pigatron-industries/xen_octasource/README.md

# OctaSource

A Eurorack synthesiser module with 8 control voltage outputs.

[Documentation](https://pigatron-industries.github.io/xen_octasource/)
