pigatron-industries/xen_octasource/docs/development.md

---
order: 3
---
# Development History

### MK1 Prototype

Used a [MikroElektronika PIXI Click](https://www.mikroe.com/pixi-click) for all inputs and outputs.

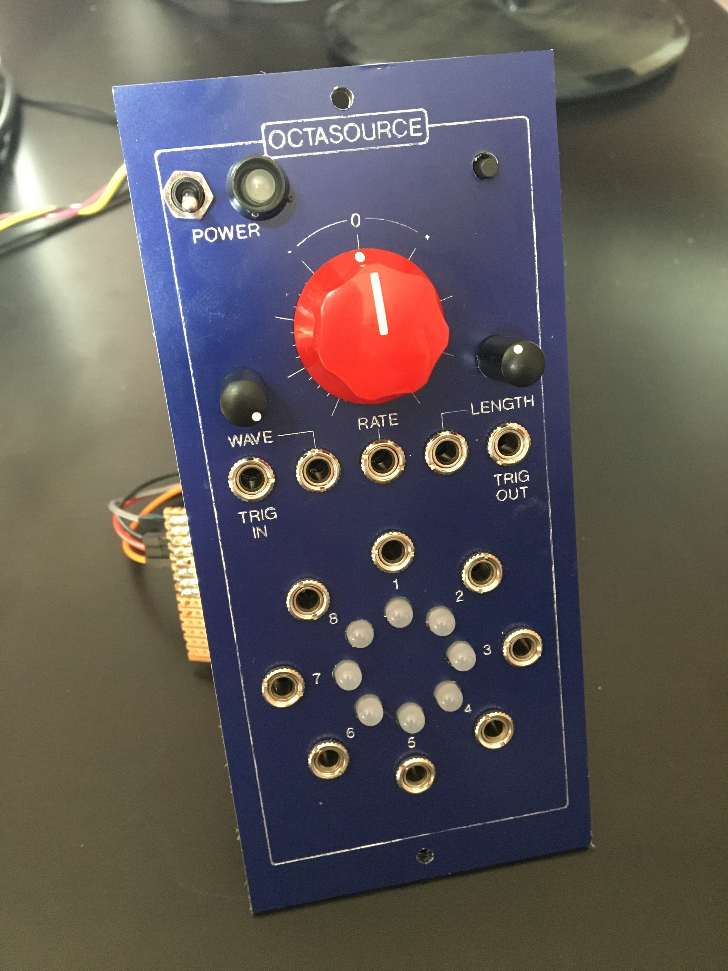
[picture p6: docs/images/octasource_mki_1.jpg]
 
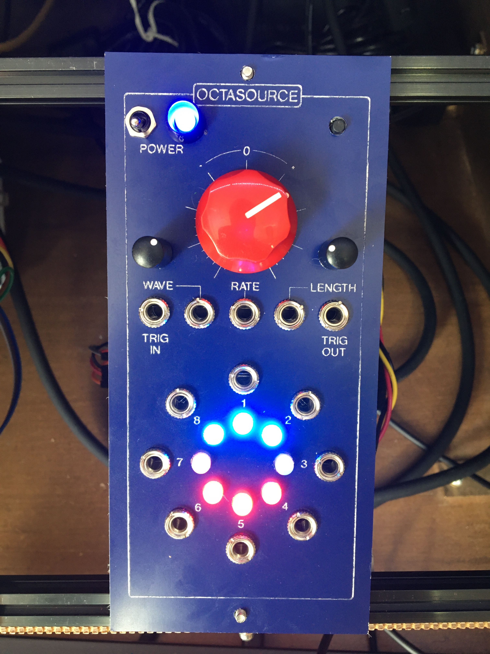
[picture p7: docs/images/octasource_mki_2.jpg]
 
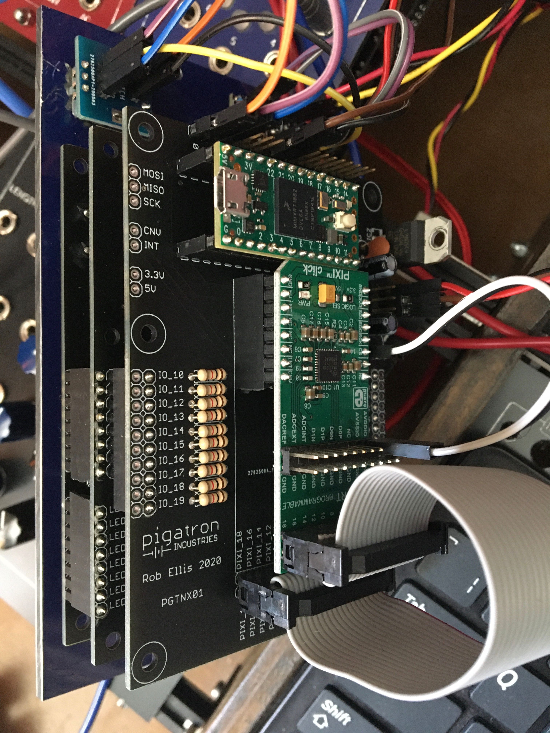
[picture p8: docs/images/octasource_mki_3.jpg]
