pigatron-industries/xen_octasource/docs/images/attractor_outputs.drawio.png

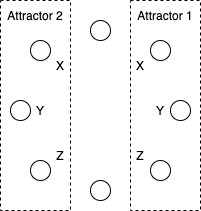
docs/images/attractor_outputs.drawio.png
