pigatron-industries/xen_octasource/docs/images/clock_divider2.drawio.png

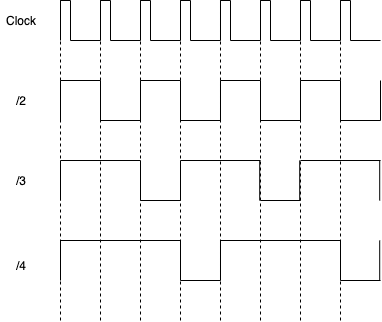
docs/images/clock_divider2.drawio.png
