pigatron-industries/xen_octasource/docs/images/clock_polyrhythm.drawio.png

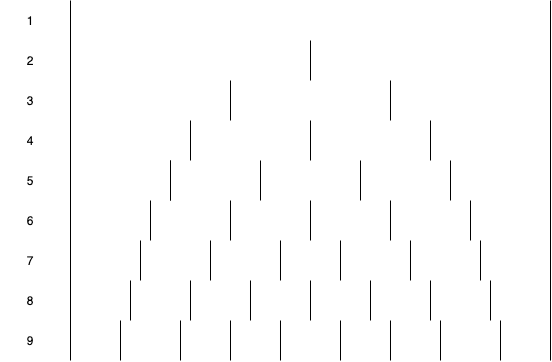
docs/images/clock_polyrhythm.drawio.png
