pigatron-industries/xen_octasource/docs/images/octasource_mkii_baseboard_brd.drawio.png

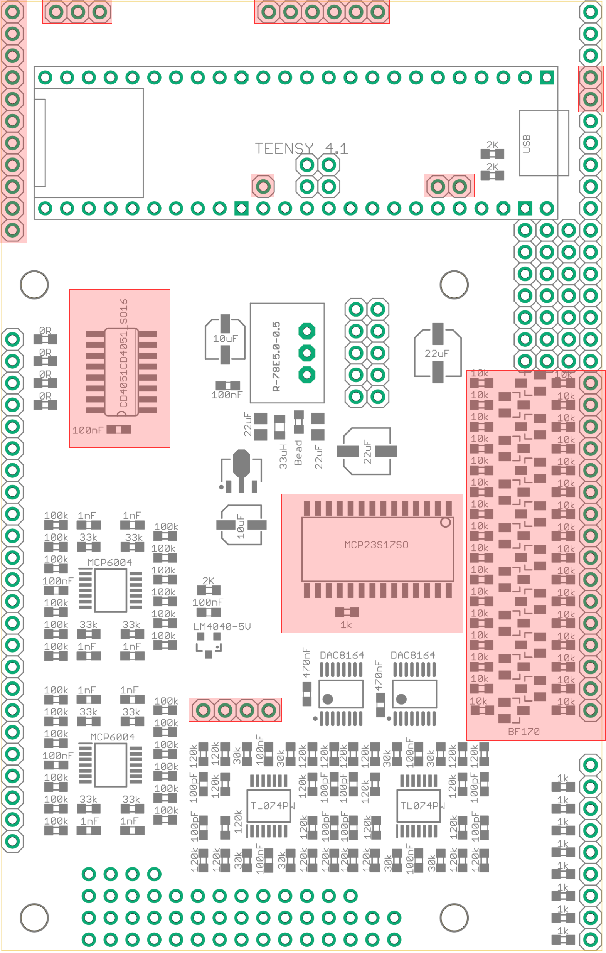
docs/images/octasource_mkii_baseboard_brd.drawio.png
