pigatron-industries/xen_octasource/docs/images/octasource_mkii_controls_brd_bottom.drawio.png

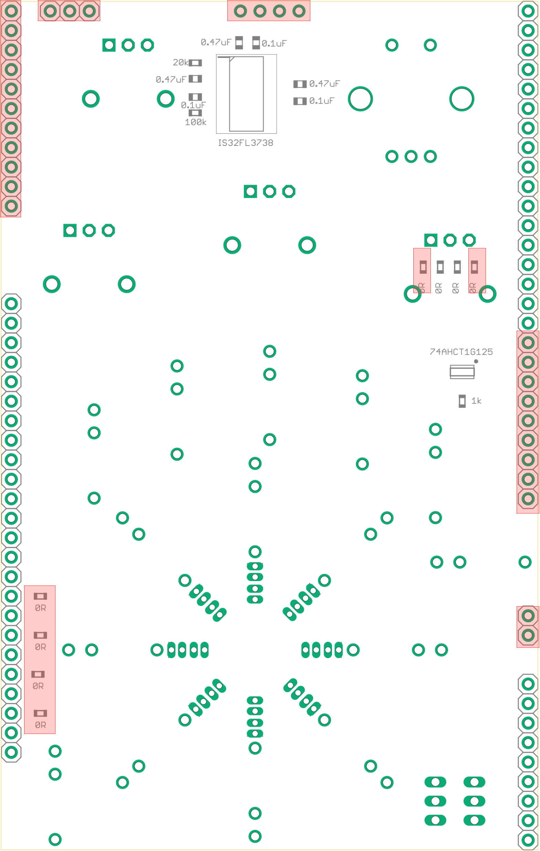
docs/images/octasource_mkii_controls_brd_bottom.drawio.png
