pigatron-industries/xen_octasource/docs/images/octasource_mkii_controls_brd_top.drawio.png

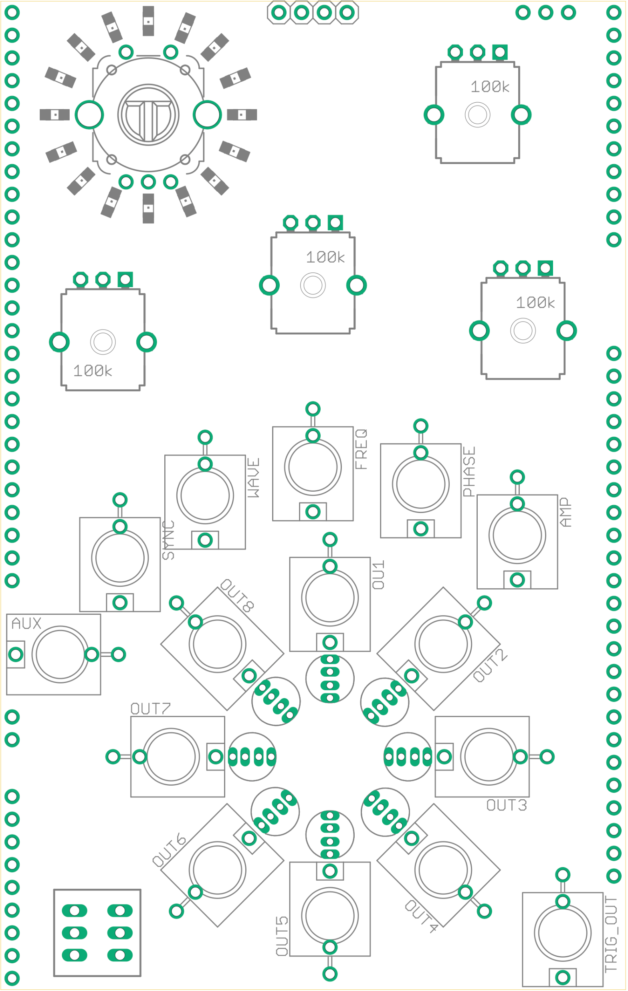
docs/images/octasource_mkii_controls_brd_top.drawio.png
