pigatron-industries/xen_octasource/docs/images/octosource_mkii.jpg

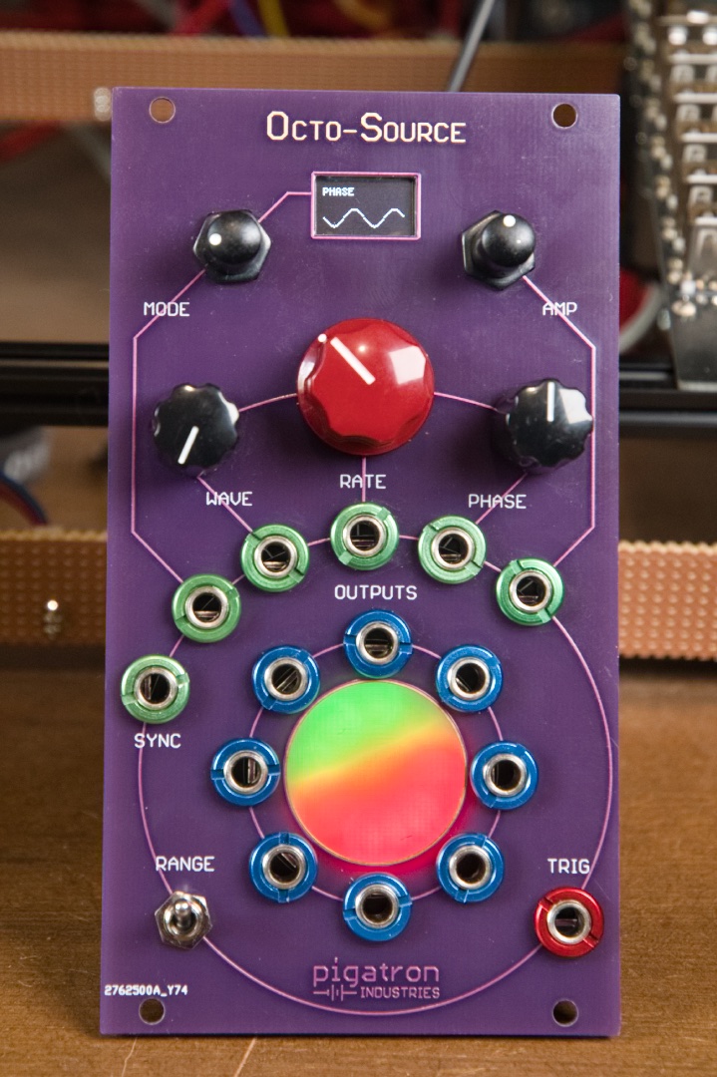
docs/images/octosource_mkii.jpg
