pigatron-industries/xen_octasource/docs/images/octosource_panel.png

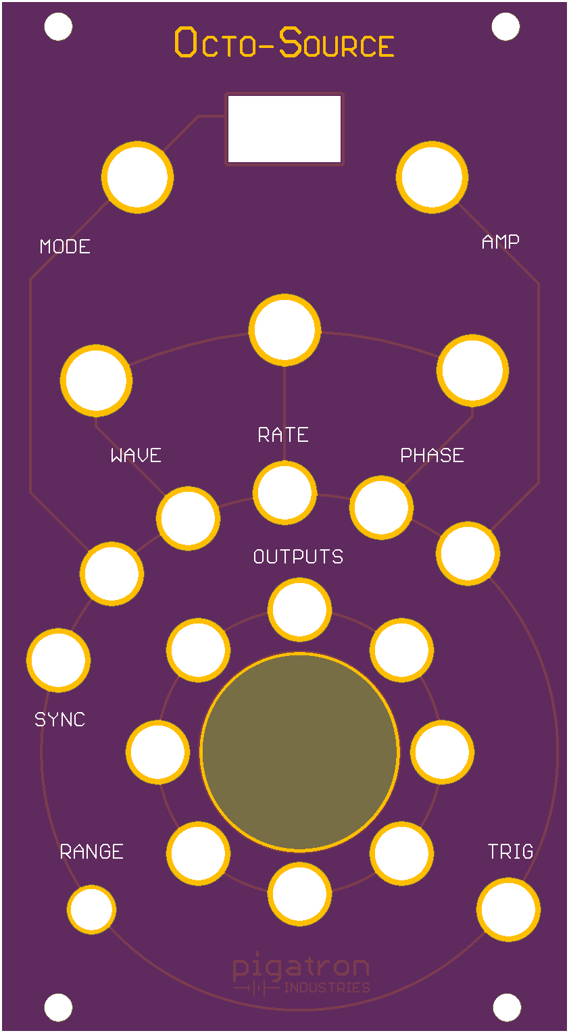
docs/images/octosource_panel.png
