pigatron-industries/xen_octasource/docs/images/pendulum_spring_outputs.drawio.png

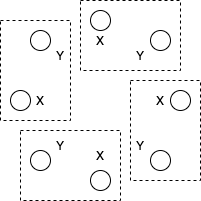
docs/images/pendulum_spring_outputs.drawio.png
