pigatron-industries/xen_octasource/docs/images/threebody_outputs.drawio.png

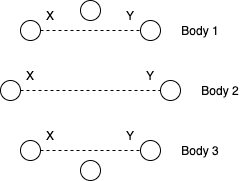
docs/images/threebody_outputs.drawio.png
