pigatron-industries/xen_octasource/docs/images/build/Photo 23-04-2022, 18 16 53.jpg

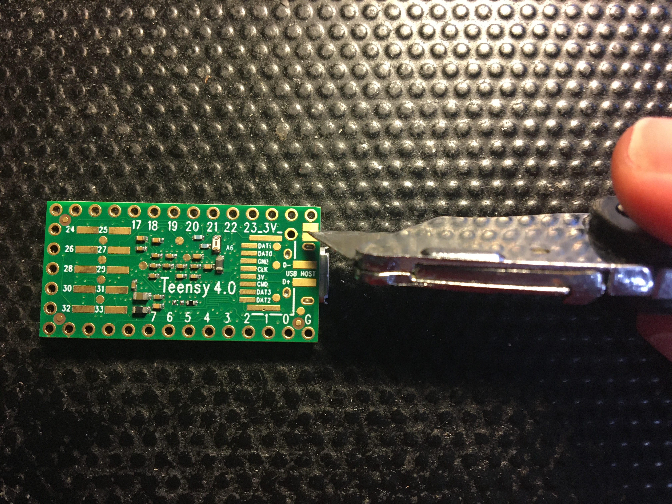
docs/images/build/Photo 23-04-2022, 18 16 53.jpg
