pigatron-industries/xen_octasource/docs/images/build/Photo 23-04-2022, 18 44 00.jpg

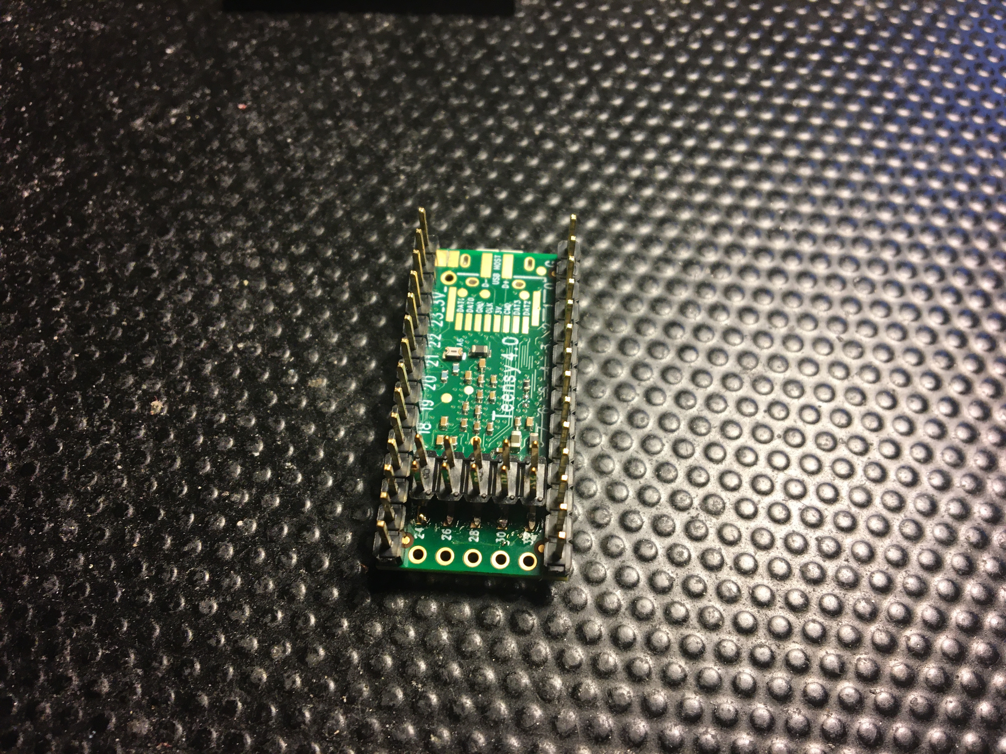
docs/images/build/Photo 23-04-2022, 18 44 00.jpg
