pigatron-industries/xen_octasource/docs/images/build/Photo 24-04-2022, 13 27 55.jpg

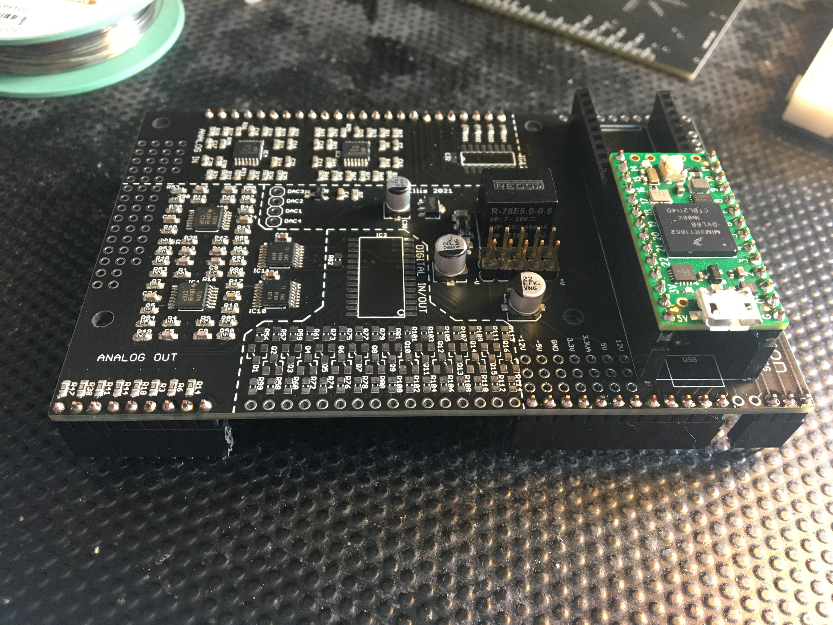
docs/images/build/Photo 24-04-2022, 13 27 55.jpg
