pigatron-industries/xen_octasource/docs/images/build/Photo 24-04-2022, 14 46 27.jpg

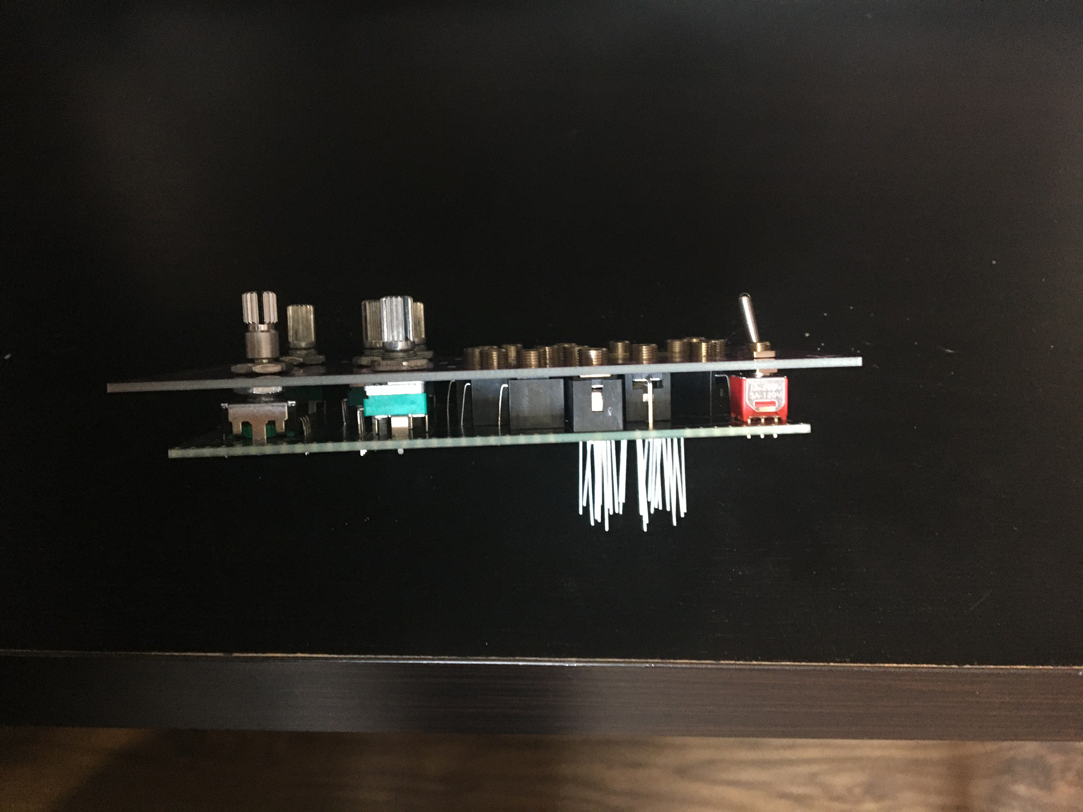
docs/images/build/Photo 24-04-2022, 14 46 27.jpg
