pigatron-industries/xen_octasource/docs/images/build/Photo 28-05-2022, 15 01 42.jpg

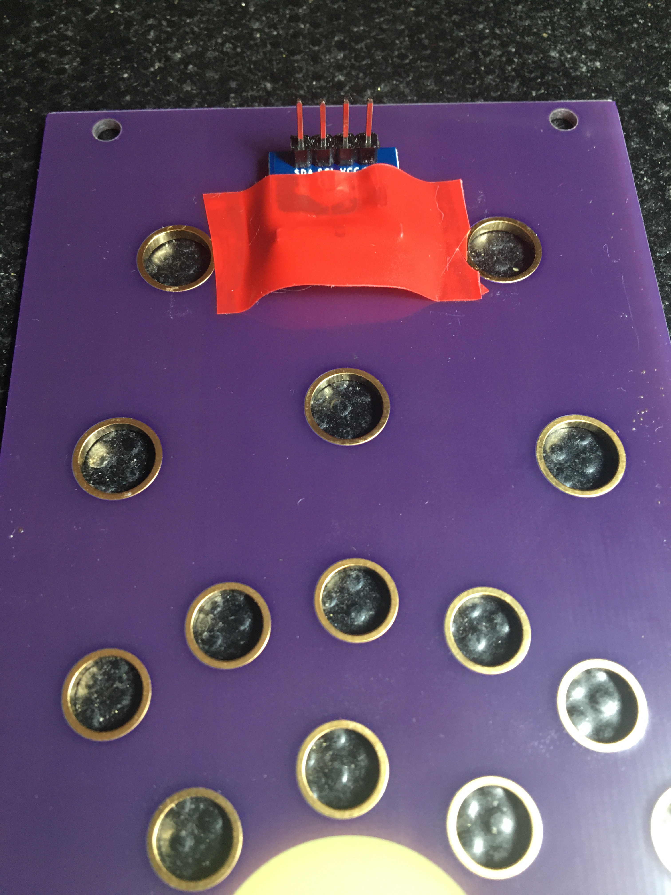
docs/images/build/Photo 28-05-2022, 15 01 42.jpg
