pigatron-industries/xen_octasource/docs/images/build/Photo 28-05-2022, 15 15 38.jpg

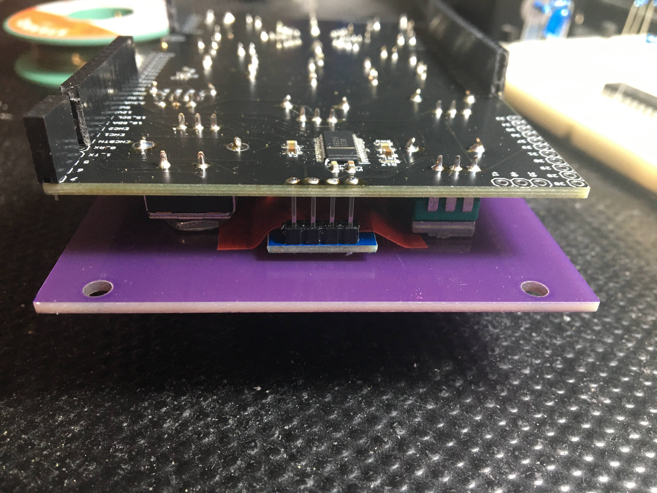
docs/images/build/Photo 28-05-2022, 15 15 38.jpg
