pigatron-industries/xen_octasource/docs/history.md

---
order: 5
---
# Development History

### MKII

{% include img.html src="images/octosource_mkii.jpg" height=400 %}

### MKI Prototype

Used a [MikroElektronika PIXI Click](https://www.mikroe.com/pixi-click) for all inputs and outputs.

{% include img.html src="images/octasource_mki_1.jpg" height=400 %} {% include img.html src="images/octasource_mki_2.jpg" height=400 %} {% include img.html src="images/octasource_mki_3.jpg" height=400 %}
