pigatron-industries/xen_octasource/hardware/mkiii/PGTN021_octasource_mkiii_panel.brd

## EAGLE design hardware/mkiii/PGTN021_octasource_mkiii_panel.brd (2023-10-28)

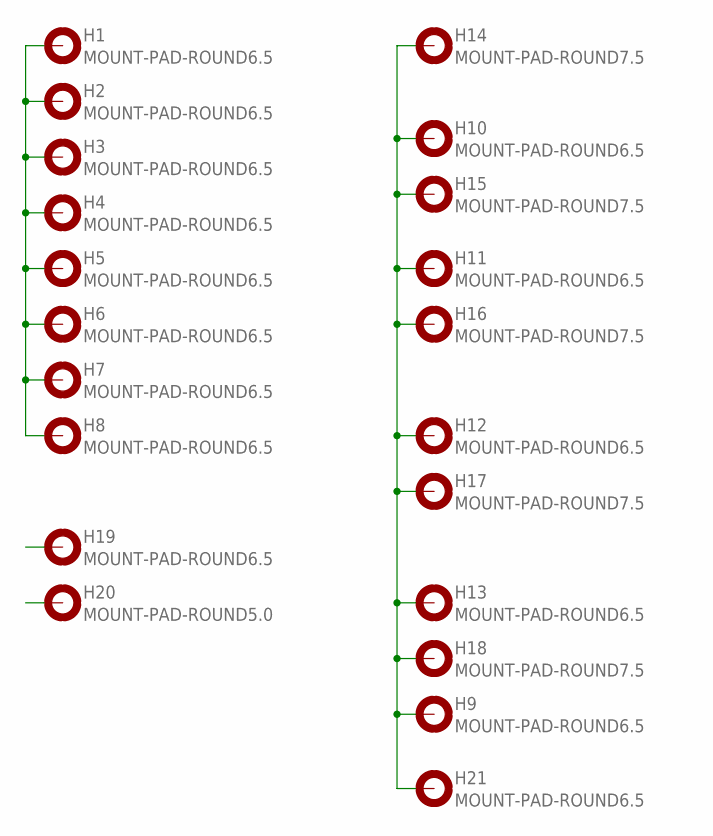
[picture p32: schematic PGTN021_octasource_mkiii_panel.sch]

Parts:
H1, H2, H3, H4, H5, H6, H7, H8, H9, H10, H11, H12, H13, H19, H21: MOUNT-PAD-ROUND6.5; 6.5-PAD
H14, H15, H16, H17, H18: MOUNT-PAD-ROUND7.5; 7.5-PAD
H20: MOUNT-PAD-ROUND5.0; 5,0-PAD

Connections:
unnamed: H9.B6.5, H10.B6.5, H11.B6.5, H12.B6.5, H13.B6.5, H14.B7.5, H15.B7.5, H16.B7.5, H17.B7.5, H18.B7.5, H21.B6.5
unnamed: H1.B6.5, H2.B6.5, H3.B6.5, H4.B6.5, H5.B6.5, H6.B6.5, H7.B6.5, H8.B6.5

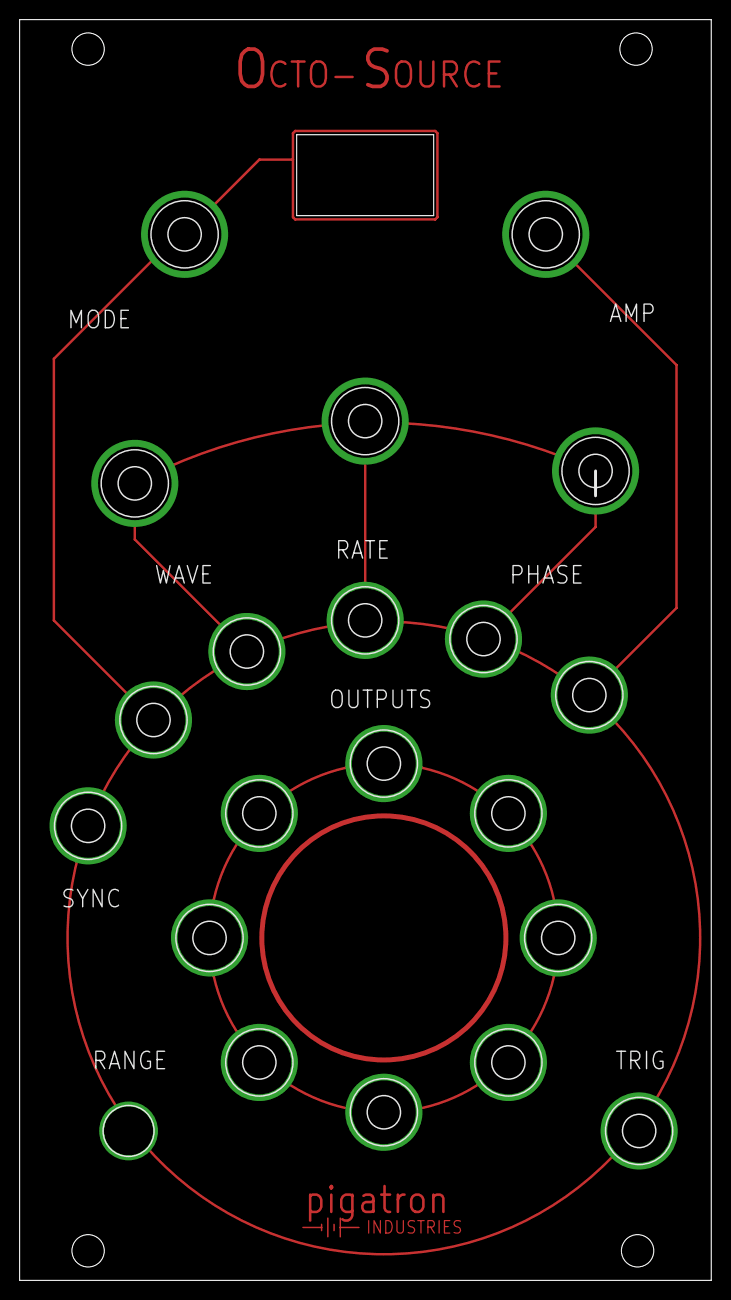
[picture p33: board PGTN021_octasource_mkiii_panel.brd from above]

Board: 2 copper layers, 70.5 x 128.6 mm, 26 parts (0 on the bottom side), 2 nets.

Other parts of the board:
U$1, U$3, U$4, U$5: 3,3
U$2: PIGATRON-LOGO-TRACE
