pigatron-industries/xen_octasource/hardware/mkiii/PGTN021_octasource_mkiii_controls.brd

## EAGLE design hardware/mkiii/PGTN021_octasource_mkiii_controls.brd (2023-10-28)

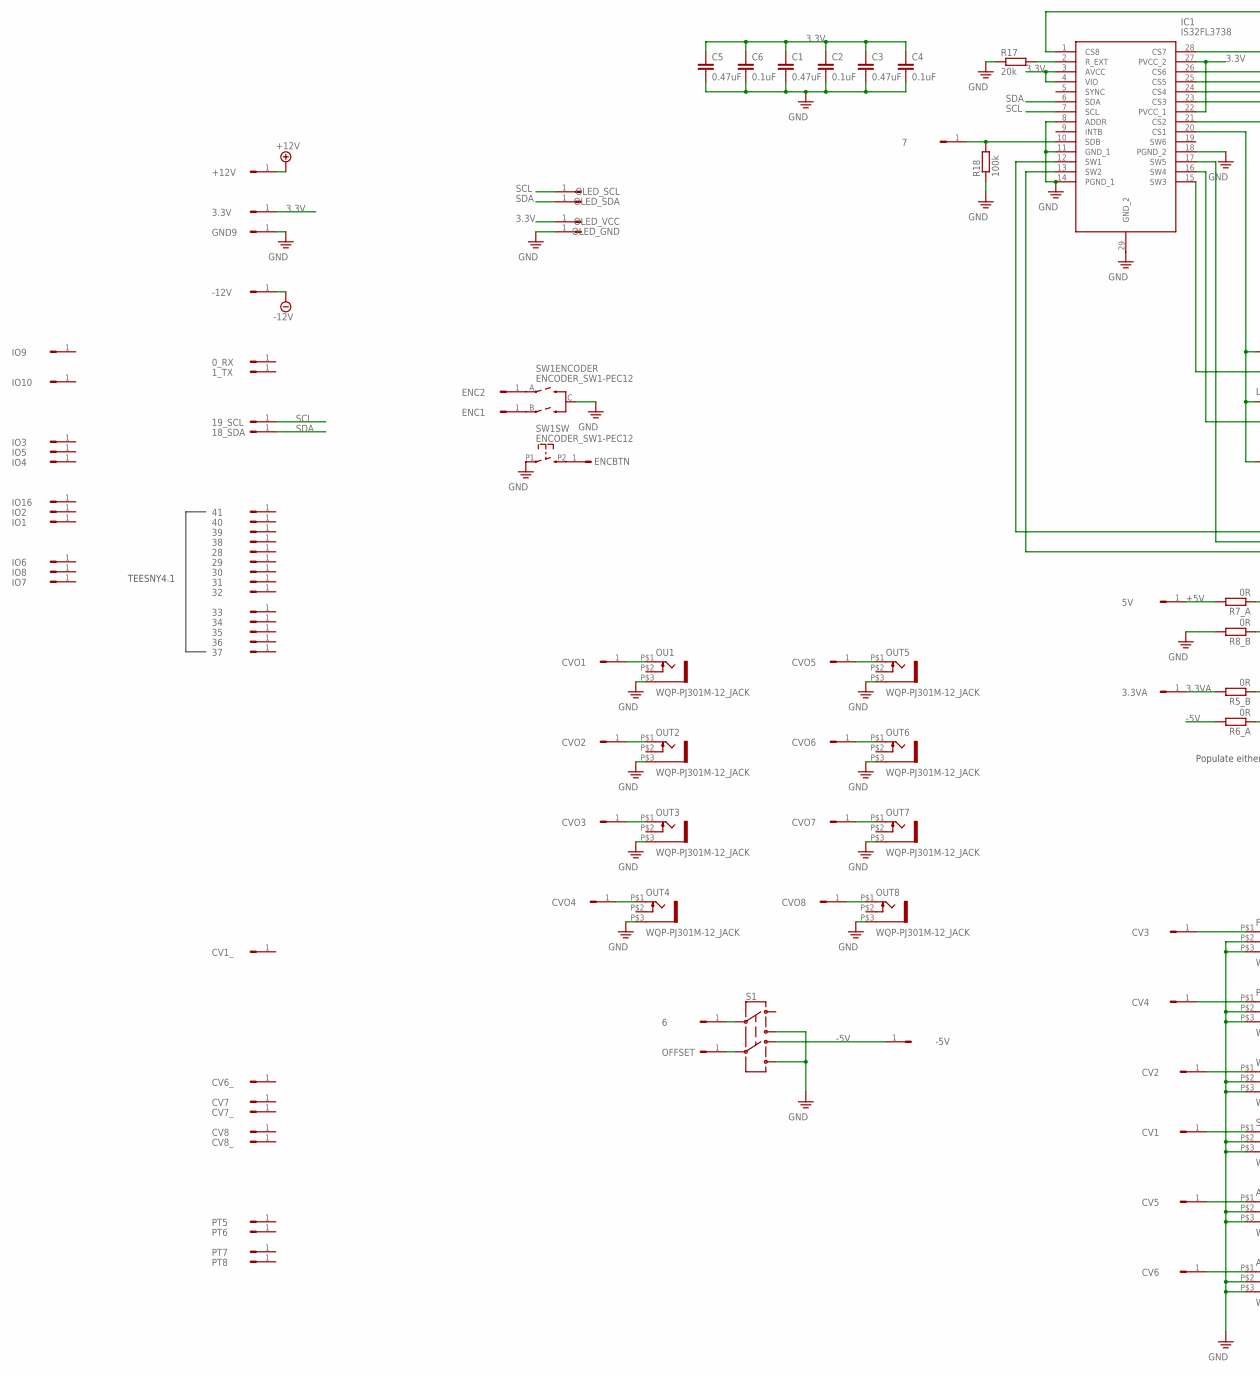
[picture p34: schematic PGTN021_octasource_mkiii_controls.sch, part in row 1, column 1]

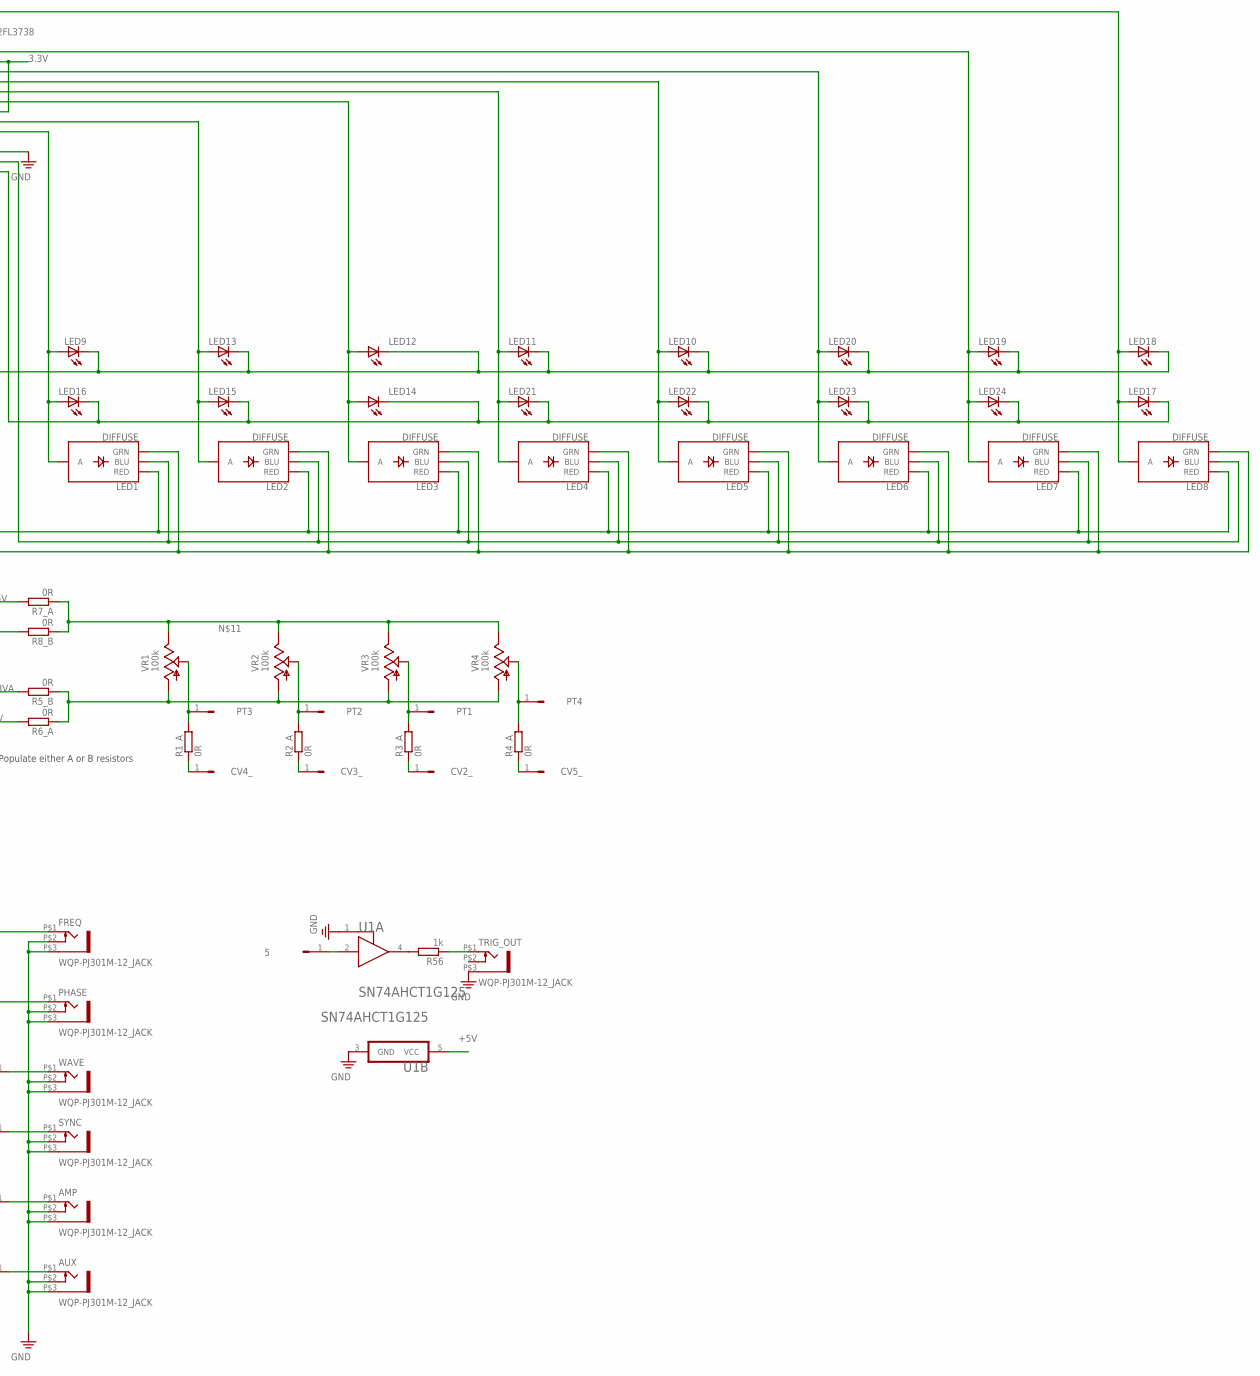
[picture p35: schematic PGTN021_octasource_mkiii_controls.sch, part in row 1, column 2]

Parts:
0_RX, 1_TX, 3.3V, 3.3VA, 5, 5V, 6, 7, 18_SDA, 19_SCL, 28, 29, 30, 31, 32, 33, 34, 35, 36, 37, 38, 39, 40, 41: HEADER/MALE/01
+12V: HEADER/MALE/01
-5V, -12V: HEADER/MALE/01
AMP: WQP-PJ301M-12_JACK
AUX: WQP-PJ301M-12_JACK
C1, C3, C5: 0.47uF; C0603
C2, C4, C6: 0.1uF; C0603
CV1, CV1_, CV2, CV2_, CV3, CV3_, CV4, CV4_, CV5, CV5_, CV6, CV6_, CV7, CV7_, CV8, CV8_: HEADER/MALE/01
CVO1, CVO2, CVO3, CVO4, CVO5, CVO6, CVO7, CVO8: HEADER/MALE/01
ENC1, ENC2: HEADER/MALE/01
ENCBTN: HEADER/MALE/01
FREQ: WQP-PJ301M-12_JACK
GND9: HEADER/MALE/01
IC1: IS32FL3738; TSSOP29
IO1, IO2, IO3, IO4, IO5, IO6, IO7, IO8, IO9, IO10, IO16: HEADER/MALE/01
LED1, LED2, LED3, LED4, LED5, LED6, LED7, LED8: DIFFUSE; LED-RGB-THRU
LED9, LED10, LED11, LED12, LED13, LED14, LED15, LED16, LED17, LED18, LED19, LED20, LED21, LED22, LED23, LED24: LEDCHIPLED_0805; CHIPLED_0805
OFFSET: HEADER/MALE/01
OLED_GND: HEADER/MALE/01
OLED_SCL: HEADER/MALE/01
OLED_SDA: HEADER/MALE/01
OLED_VCC: HEADER/MALE/01
OU1: WQP-PJ301M-12_JACK
OUT2, OUT3, OUT4, OUT5, OUT6, OUT7, OUT8: WQP-PJ301M-12_JACK
PHASE: WQP-PJ301M-12_JACK
PT1, PT2, PT3, PT4, PT5, PT6, PT7, PT8: HEADER/MALE/01
R1_A, R2_A, R3_A, R4_A, R5_B, R6_A, R7_A, R8_B: 0R; R0603
R17: 20k; R0603
R18: 100k; R0603
R56: 1k; R0603
S1: SWITCH-DPDTPTH2; SWITCH-DPDT_SUB_ROUND
SW1: ENCODER_SW1-PEC12; PEC12_INCREMENTAL_ENCODER
SYNC: WQP-PJ301M-12_JACK
TRIG_OUT: WQP-PJ301M-12_JACK
U1: 74AHCT1G125
VR1, VR2, VR3, VR4: 100k; 9MM_SNAP-IN_POT
WAVE: WQP-PJ301M-12_JACK

Connections:
3.3V: 3.3V.1, C1.1, C2.1, C3.1, C4.1, C5.1, C6.1, IC1.3 (AVCC), IC1.4 (VIO), IC1.22 (PVCC_1), IC1.27 (PVCC_2), OLED_VCC.1
3.3VA: 3.3VA.1, R5_B.2
+5V: 5V.1, R7_A.2, U1.5 (VCC)
+12V: +12V.1
-5V: -5V.1, R6_A.2, S1.4
-12V: -12V.1
unnamed: IC1.12 (SW1), LED1.1 (RED), LED2.1 (RED), LED3.1 (RED), LED4.1 (RED), LED5.1 (RED), LED6.1 (RED), LED7.1 (RED), LED8.1 (RED)
unnamed: PT3.1, R1_A.2, VR1.2 (S)
unnamed: IC1.17 (SW5), LED1.4 (BLU), LED2.4 (BLU), LED3.4 (BLU), LED4.4 (BLU), LED5.4 (BLU), LED6.4 (BLU), LED7.4 (BLU), LED8.4 (BLU)
unnamed: CVO1.1, OU1.P$1 (2)
unnamed: 6.1, S1.2
unnamed: IC1.13 (SW2), LED1.3 (GRN), LED2.3 (GRN), LED3.3 (GRN), LED4.3 (GRN), LED5.3 (GRN), LED6.3 (GRN), LED7.3 (GRN), LED8.3 (GRN)
unnamed: PT2.1, R2_A.2, VR2.2 (S)
unnamed: CVO2.1, OUT2.P$1 (2)
unnamed: PT1.1, R3_A.2, VR3.2 (S)
unnamed: PT4.1, R4_A.2, VR4.2 (S)
unnamed: R7_A.1, R8_B.1, VR1.3 (E), VR2.3 (E), VR3.3 (E), VR4.3 (E)
unnamed: CVO3.1, OUT3.P$1 (2)
unnamed: OFFSET.1, S1.5
unnamed: AUX.P$1 (2), CV6.1
unnamed: CV4_.1, R1_A.1
unnamed: CVO4.1, OUT4.P$1 (2)
unnamed: CV3_.1, R2_A.1
unnamed: CV2_.1, R3_A.1
unnamed: CV5_.1, R4_A.1
unnamed: CVO5.1, OUT5.P$1 (2)
unnamed: R5_B.1, R6_A.1, VR1.1 (A), VR2.1 (A), VR3.1 (A), VR4.1 (A)
unnamed: CVO6.1, OUT6.P$1 (2)
unnamed: CVO7.1, OUT7.P$1 (2)
unnamed: CVO8.1, OUT8.P$1 (2)
unnamed: 7.1, IC1.10 (SDB), R18.2
unnamed: R56.2, U1.4 (Y)
unnamed: 5.1, U1.2 (A)
unnamed: ENCBTN.1, SW1.P2 (2)
unnamed: ENC2.1, SW1.A
unnamed: ENC1.1, SW1.B
unnamed: CV1.1, SYNC.P$1 (2)
unnamed: CV2.1, WAVE.P$1 (2)
unnamed: CV3.1, FREQ.P$1 (2)
unnamed: CV4.1, PHASE.P$1 (2)
unnamed: AMP.P$1 (2), CV5.1
unnamed: R56.1, TRIG_OUT.P$1 (2)
unnamed: IC1.20 (CS1), LED1.2 (A), LED9.A, LED16.A
unnamed: IC1.21 (CS2), LED2.2 (A), LED13.A, LED15.A
unnamed: IC1.23 (CS3), LED3.2 (A), LED12.A, LED14.A
unnamed: IC1.16 (SW4), LED14.C, LED15.C, LED16.C, LED17.C, LED21.C, LED22.C, LED23.C, LED24.C
unnamed: IC1.15 (SW3), LED9.C, LED10.C, LED11.C, LED12.C, LED13.C, LED18.C, LED19.C, LED20.C
unnamed: IC1.24 (CS4), LED4.2 (A), LED11.A, LED21.A
unnamed: IC1.25 (CS5), LED5.2 (A), LED10.A, LED22.A
unnamed: IC1.26 (CS6), LED6.2 (A), LED20.A, LED23.A
unnamed: IC1.28 (CS7), LED7.2 (A), LED19.A, LED24.A
unnamed: IC1.1 (CS8), LED8.2 (A), LED17.A, LED18.A
unnamed: IC1.2 (R_EXT), R17.2
PE: AMP.P$2 (3), AMP.P$3 (1), AUX.P$2 (3), AUX.P$3 (1), C1.2, C2.2, C3.2, C4.2, C5.2, C6.2, FREQ.P$2 (3), FREQ.P$3 (1), GND9.1, IC1.8 (ADDR), IC1.11 (GND_1), IC1.14 (PGND_1), IC1.18 (PGND_2), IC1.29 (GND_2), OLED_GND.1, OU1.P$3 (1), OUT2.P$3 (1), OUT3.P$3 (1), OUT4.P$3 (1), OUT5.P$3 (1), OUT6.P$3 (1), OUT7.P$3 (1), OUT8.P$3 (1), PHASE.P$2 (3), PHASE.P$3 (1), R8_B.2, R17.1, R18.1, S1.3, S1.6, SW1.C, SW1.P1 (1), SYNC.P$2 (3), SYNC.P$3 (1), TRIG_OUT.P$3 (1), U1.1 (!OE!), U1.3 (GND), WAVE.P$2 (3), WAVE.P$3 (1)
SCL: 19_SCL.1, IC1.7 (SCL), OLED_SCL.1
SDA: 18_SDA.1, IC1.6 (SDA), OLED_SDA.1

Notes on the sheet:
TEESNY4.1
Populate either A or B resistors

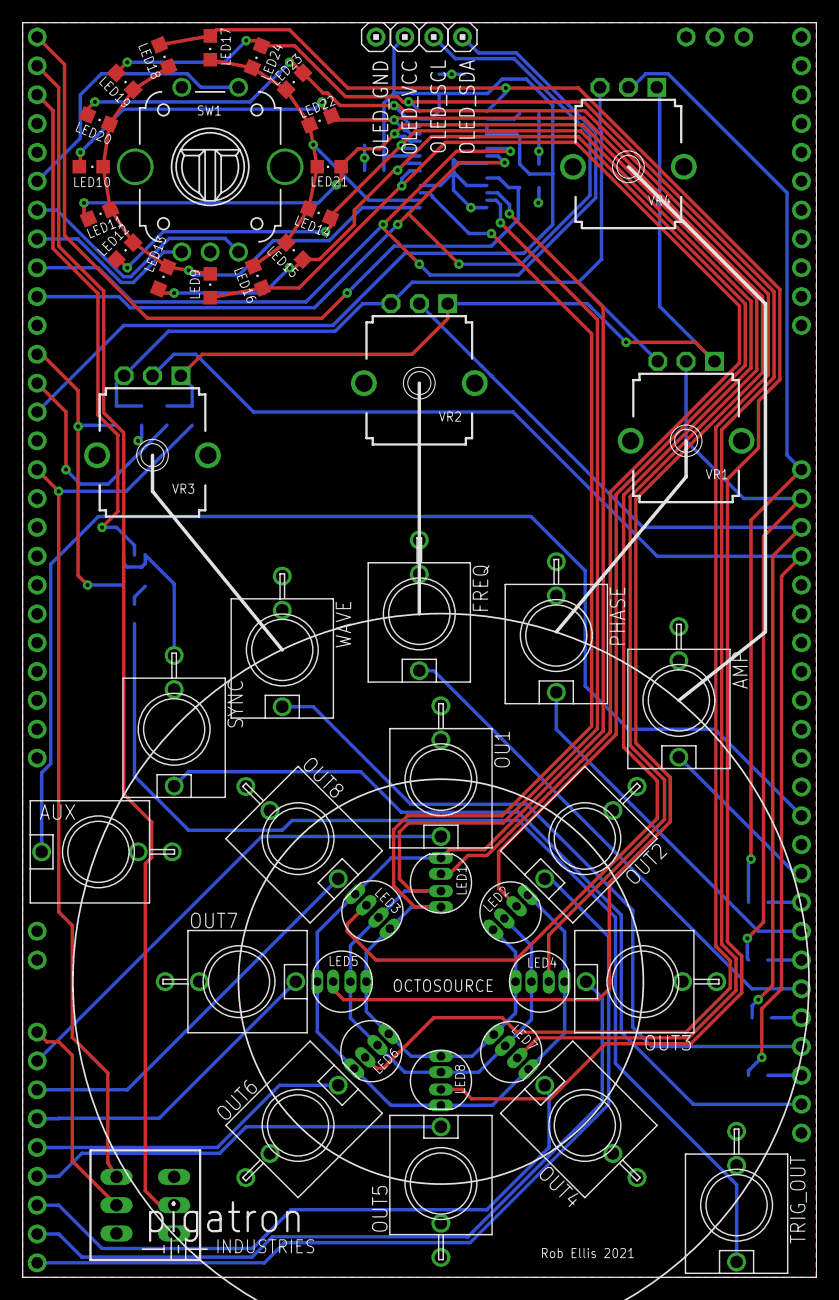
[picture p36: board PGTN021_octasource_mkiii_controls.brd from above]

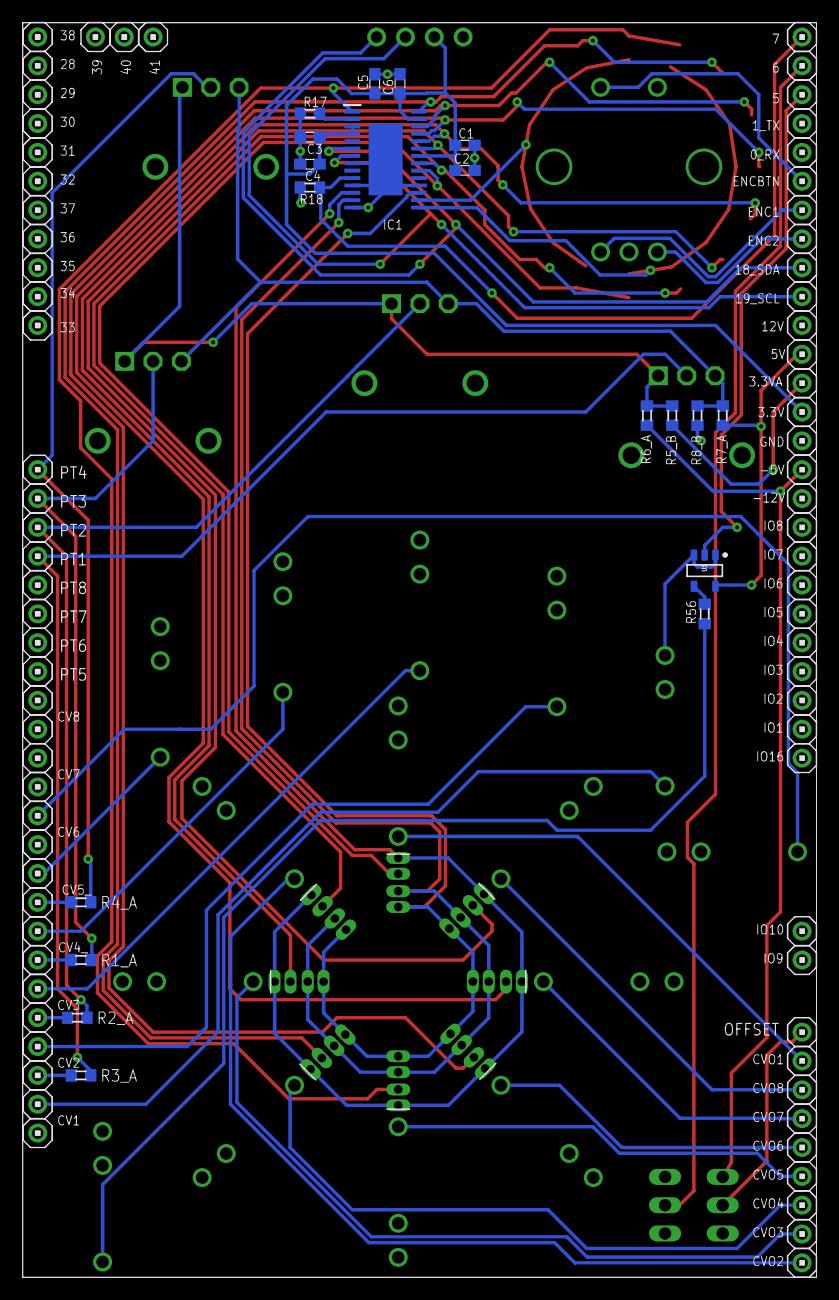
[picture p37: board PGTN021_octasource_mkiii_controls.brd from below]

Board: 2 copper layers, 69.9 x 110.5 mm, 144 parts (94 on the bottom side), 54 nets.

Other parts of the board:
U$1: PIGATRON-LOGO
