pigatron-industries/xen_octasource/hardware/mki/PGTN021_octasource_mki_controls.brd

## EAGLE design hardware/mki/PGTN021_octasource_mki_controls.brd (2021-05-31)

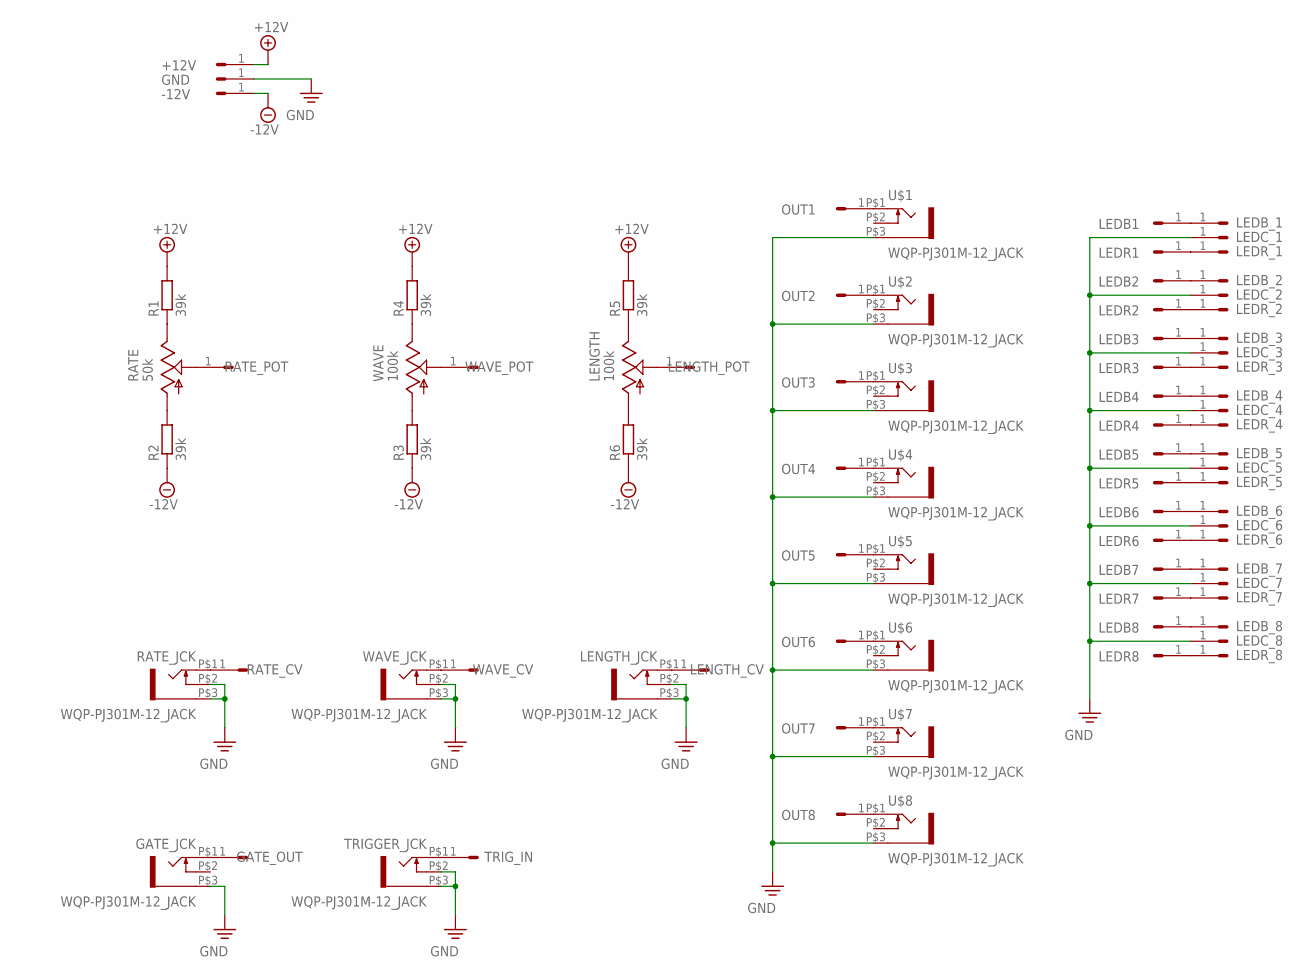
[picture p38: schematic PGTN021_octasource_mki_controls.sch]

Parts:
+12V: HEADER/MALE/01
-12V: HEADER/MALE/01
GATE_JCK: WQP-PJ301M-12_JACK
GATE_OUT: HEADER/MALE/01
GND: HEADER/MALE/01
LEDB1, LEDB2, LEDB3, LEDB4, LEDB5, LEDB6, LEDB7, LEDB8: HEADER/MALE/01
LEDB_1, LEDB_2, LEDB_3, LEDB_4, LEDB_5, LEDB_6, LEDB_7, LEDB_8: HEADER/MALE/01
LEDC_1, LEDC_2, LEDC_3, LEDC_4, LEDC_5, LEDC_6, LEDC_7, LEDC_8: HEADER/MALE/01
LEDR1, LEDR2, LEDR3, LEDR4, LEDR5, LEDR6, LEDR7, LEDR8: HEADER/MALE/01
LEDR_1, LEDR_2, LEDR_3, LEDR_4, LEDR_5, LEDR_6, LEDR_7, LEDR_8: HEADER/MALE/01
LENGTH: 100k; 9MM_SNAP-IN_POT
LENGTH_CV: HEADER/MALE/01
LENGTH_JCK: WQP-PJ301M-12_JACK
LENGTH_POT: HEADER/MALE/01
OUT1, OUT2, OUT3, OUT4, OUT5, OUT6, OUT7, OUT8: HEADER/MALE/01
R1, R2, R3, R4, R5, R6: 39k; RESISTOR/7.5
RATE: 50k; 9MM_SNAP-IN_POT
RATE_CV: HEADER/MALE/01
RATE_JCK: WQP-PJ301M-12_JACK
RATE_POT: HEADER/MALE/01
TRIGGER_JCK: WQP-PJ301M-12_JACK
TRIG_IN: HEADER/MALE/01
U$1, U$2, U$3, U$4, U$5, U$6, U$7, U$8: WQP-PJ301M-12_JACK
WAVE: 100k; 9MM_SNAP-IN_POT
WAVE_CV: HEADER/MALE/01
WAVE_JCK: WQP-PJ301M-12_JACK
WAVE_POT: HEADER/MALE/01

Connections:
+12V: +12V.1, R1.2, R4.2, R5.2
-12V: -12V.1, R2.1, R3.1, R6.1
unnamed: R2.2, RATE.1 (A)
unnamed: R1.1, RATE.3 (E)
unnamed: RATE_CV.1, RATE_JCK.P$1 (2)
unnamed: RATE.2 (S), RATE_POT.1
unnamed: R3.2, WAVE.1 (A)
unnamed: R4.1, WAVE.3 (E)
unnamed: WAVE.2 (S), WAVE_POT.1
unnamed: LENGTH.3 (E), R5.1
unnamed: LENGTH.1 (A), R6.2
unnamed: LENGTH.2 (S), LENGTH_POT.1
unnamed: LENGTH_CV.1, LENGTH_JCK.P$1 (2)
unnamed: WAVE_CV.1, WAVE_JCK.P$1 (2)
unnamed: GATE_JCK.P$1 (2), GATE_OUT.1
unnamed: OUT1.1, U$1.P$1 (2)
unnamed: OUT2.1, U$2.P$1 (2)
unnamed: OUT3.1, U$3.P$1 (2)
unnamed: OUT4.1, U$4.P$1 (2)
unnamed: OUT5.1, U$5.P$1 (2)
unnamed: OUT6.1, U$6.P$1 (2)
unnamed: OUT7.1, U$7.P$1 (2)
unnamed: OUT8.1, U$8.P$1 (2)
unnamed: LEDB1.1, LEDB_1.1
unnamed: LEDB2.1, LEDB_2.1
unnamed: LEDB3.1, LEDB_3.1
unnamed: LEDB4.1, LEDB_4.1
unnamed: LEDB5.1, LEDB_5.1
unnamed: LEDB6.1, LEDB_6.1
unnamed: LEDB7.1, LEDB_7.1
unnamed: LEDB8.1, LEDB_8.1
unnamed: LEDR1.1, LEDR_1.1
unnamed: LEDR2.1, LEDR_2.1
unnamed: LEDR3.1, LEDR_3.1
unnamed: LEDR4.1, LEDR_4.1
unnamed: LEDR5.1, LEDR_5.1
unnamed: LEDR6.1, LEDR_6.1
unnamed: LEDR7.1, LEDR_7.1
unnamed: LEDR8.1, LEDR_8.1
unnamed: TRIGGER_JCK.P$1 (2), TRIG_IN.1
PE: GATE_JCK.P$3 (1), GND.1, LEDC_1.1, LEDC_2.1, LEDC_3.1, LEDC_4.1, LEDC_5.1, LEDC_6.1, LEDC_7.1, LEDC_8.1, LENGTH_JCK.P$2 (3), LENGTH_JCK.P$3 (1), RATE_JCK.P$2 (3), RATE_JCK.P$3 (1), TRIGGER_JCK.P$2 (3), TRIGGER_JCK.P$3 (1), U$1.P$3 (1), U$2.P$3 (1), U$3.P$3 (1), U$4.P$3 (1), U$5.P$3 (1), U$6.P$3 (1), U$7.P$3 (1), U$8.P$3 (1), WAVE_JCK.P$2 (3), WAVE_JCK.P$3 (1)

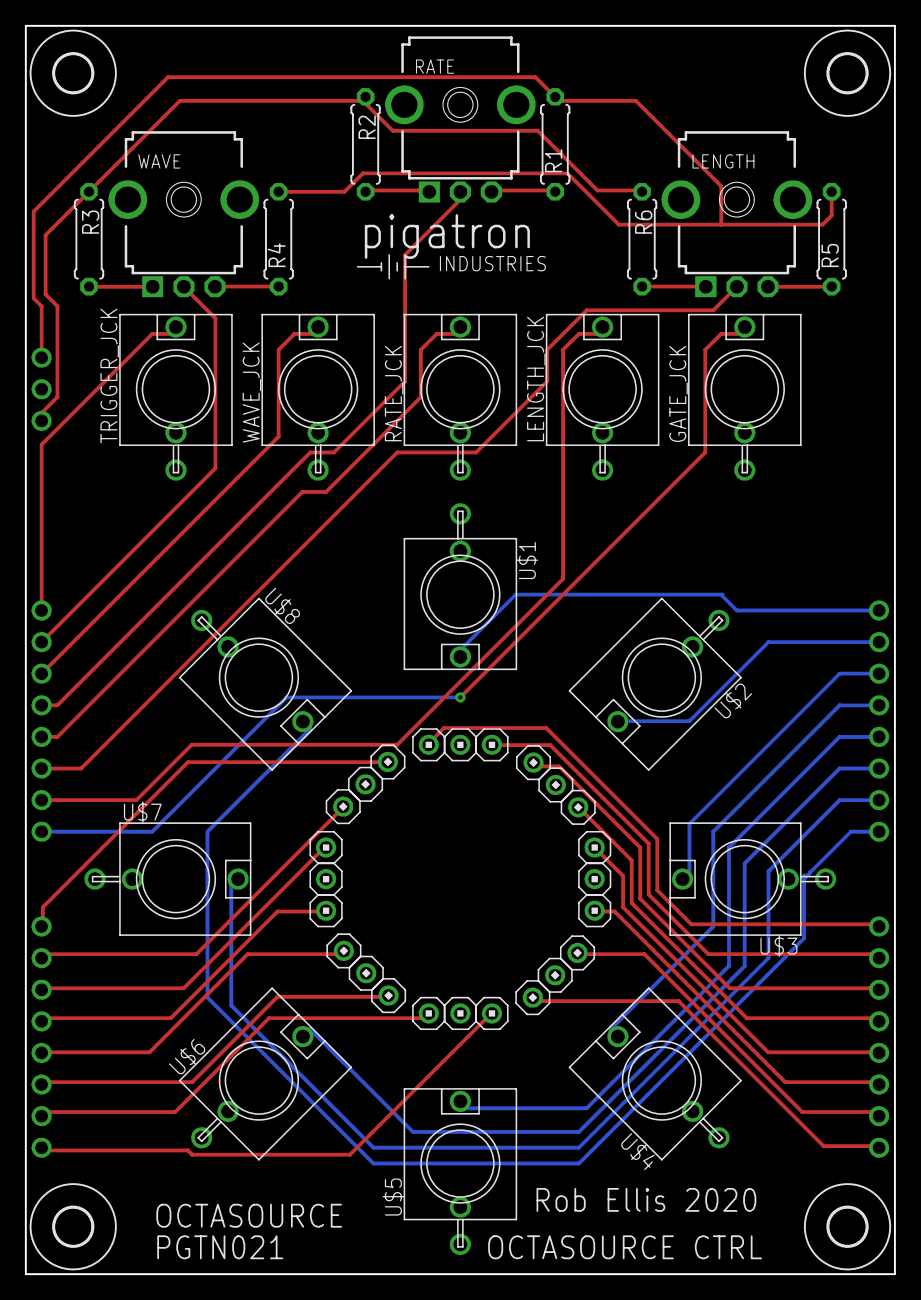
[picture p39: board PGTN021_octasource_mki_controls.brd from above]

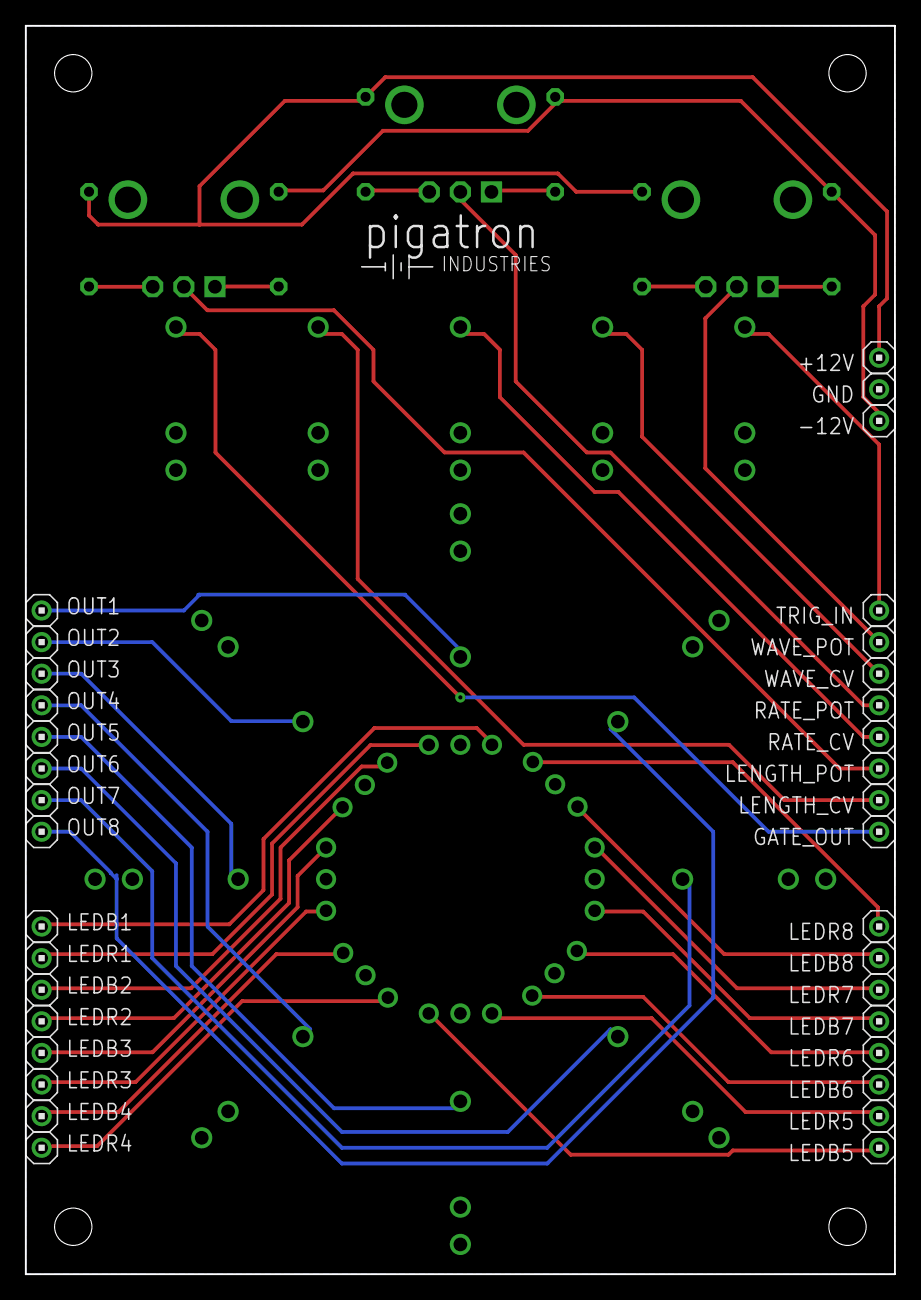
[picture p40: board PGTN021_octasource_mki_controls.brd from below]

Board: 2 copper layers, 69.8 x 100.3 mm, 87 parts (36 on the bottom side), 41 nets.

Other parts of the board:
U$9, U$10, U$11, U$12: STANDOFF/3.0
U$13, U$14: PIGATRON-LOGO
