pigatron-industries/xen_octasource/hardware/mki/PGTN021_octasource_mki_led_drivers.brd

## EAGLE design hardware/mki/PGTN021_octasource_mki_led_drivers.brd (2020-04-04)

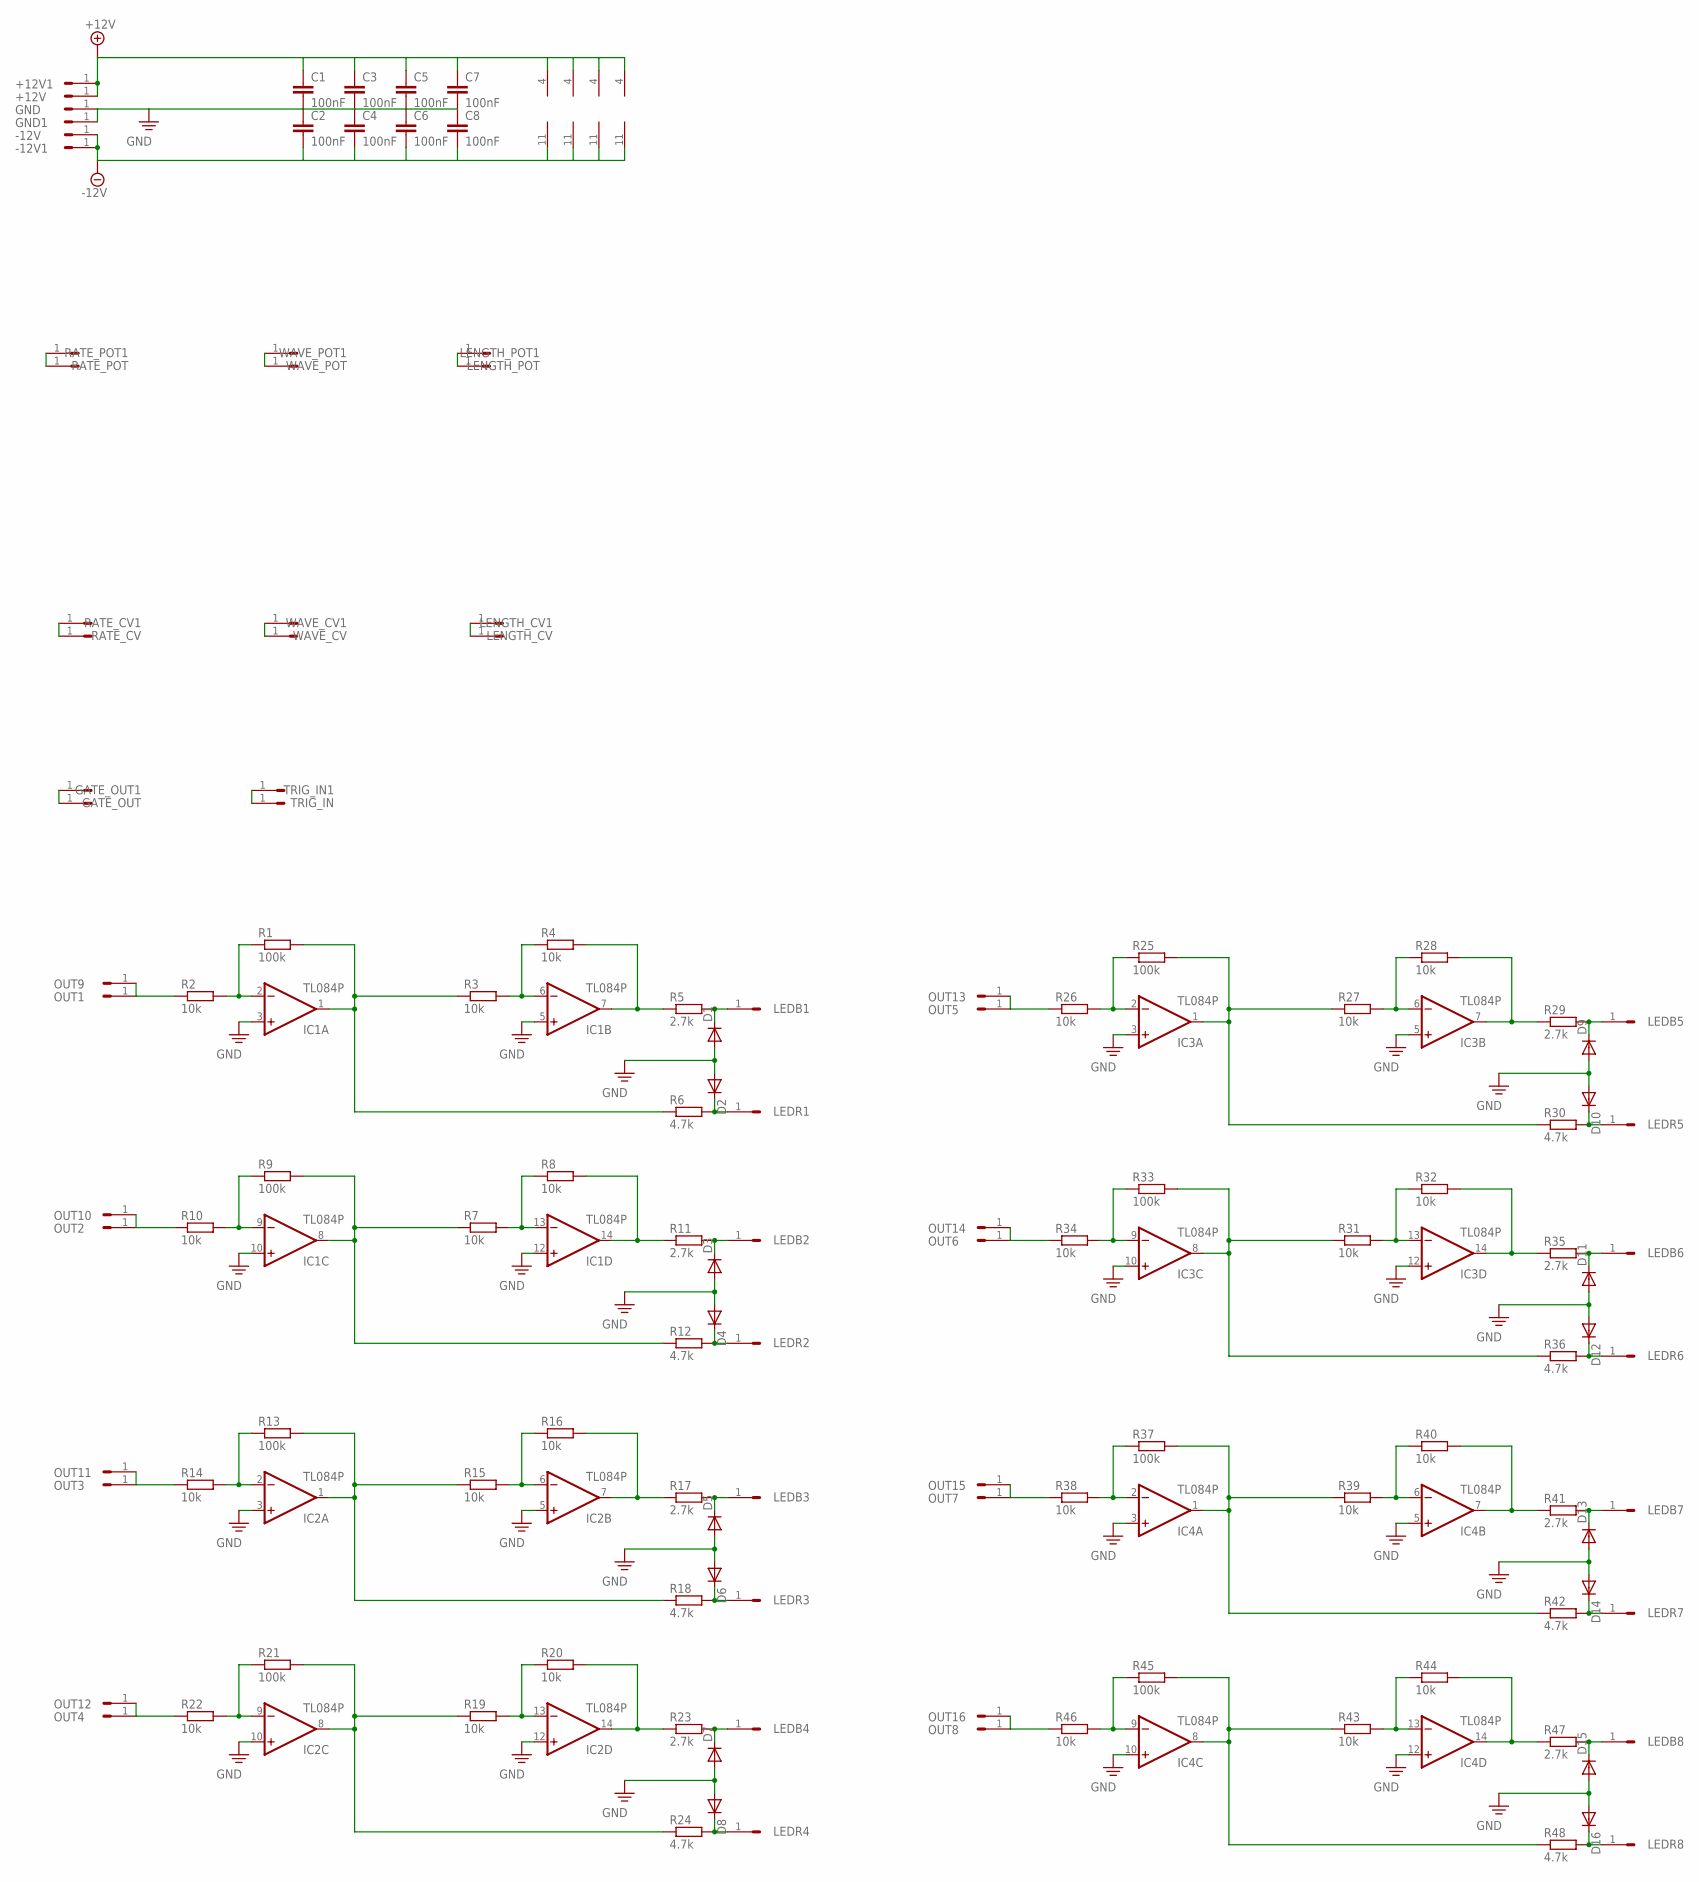
[picture p41: schematic PGTN021_octasource_mki_led_drivers.sch]

Parts:
+12V, +12V1: HEADER/MALE/01
-12V, -12V1: HEADER/MALE/01
C1, C2, C3, C4, C5, C6, C7, C8: 100nF; CERAMICDISC/5
D1, D2, D3, D4, D5, D6, D7, D8, D9, D10, D11, D12, D13, D14, D15, D16: 1N4148DO35-7; DO35-7
GATE_OUT, GATE_OUT1: HEADER/MALE/01
GND, GND1: HEADER/MALE/01
IC1, IC2, IC3, IC4: TL084P; DIL14
LEDB1, LEDB2, LEDB3, LEDB4, LEDB5, LEDB6, LEDB7, LEDB8: HEADER/MALE/01
LEDR1, LEDR2, LEDR3, LEDR4, LEDR5, LEDR6, LEDR7, LEDR8: HEADER/MALE/01
LENGTH_CV, LENGTH_CV1: HEADER/MALE/01
LENGTH_POT, LENGTH_POT1: HEADER/MALE/01
OUT1, OUT2, OUT3, OUT4, OUT5, OUT6, OUT7, OUT8, OUT9, OUT10, OUT11, OUT12, OUT13, OUT14, OUT15, OUT16: HEADER/MALE/01
R1, R9, R13, R21, R25, R33, R37, R45: 100k; RESISTOR/7.5
R2, R3, R4, R7, R8, R10, R14, R15, R16, R19, R20, R22, R26, R27, R28, R31, R32, R34, R38, R39, R40, R43, R44, R46: 10k; RESISTOR/7.5
R5, R11, R17, R23, R29, R35, R41, R47: 2.7k; RESISTOR/7.5
R6, R12, R18, R24, R30, R36, R42, R48: 4.7k; RESISTOR/7.5
RATE_CV, RATE_CV1: HEADER/MALE/01
RATE_POT, RATE_POT1: HEADER/MALE/01
TRIG_IN, TRIG_IN1: HEADER/MALE/01
WAVE_CV, WAVE_CV1: HEADER/MALE/01
WAVE_POT, WAVE_POT1: HEADER/MALE/01

Connections:
+12V: +12V.1, +12V1.1, C1.1, C3.1, C5.1, C7.1, IC1.4 (V+), IC2.4 (V+), IC3.4 (V+), IC4.4 (V+)
-12V: -12V.1, -12V1.1, C2.2, C4.2, C6.2, C8.2, IC1.11 (V-), IC2.11 (V-), IC3.11 (V-), IC4.11 (V-)
unnamed: IC1.6 (-IN), R3.2, R4.1
unnamed: IC1.2 (-IN), R1.1, R2.2
unnamed: IC1.1 (OUT), R1.2, R3.1, R6.1
unnamed: OUT1.1, OUT9.1, R2.1
unnamed: IC1.7 (OUT), R4.2, R5.1
unnamed: D1.C, LEDB1.1, R5.2
unnamed: D2.C, LEDR1.1, R6.2
unnamed: IC1.13 (-IN), R7.2, R8.1
unnamed: IC1.9 (-IN), R9.1, R10.2
unnamed: OUT2.1, OUT10.1, R10.1
unnamed: IC1.14 (OUT), R8.2, R11.1
unnamed: IC1.8 (OUT), R7.1, R9.2, R12.1
unnamed: IC2.2 (-IN), R13.1, R14.2
unnamed: D3.C, LEDB2.1, R11.2
unnamed: D4.C, LEDR2.1, R12.2
unnamed: IC2.1 (OUT), R13.2, R15.1, R18.1
unnamed: IC2.6 (-IN), R15.2, R16.1
unnamed: OUT3.1, OUT11.1, R14.1
unnamed: IC2.7 (OUT), R16.2, R17.1
unnamed: D5.C, LEDB3.1, R17.2
unnamed: D6.C, LEDR3.1, R18.2
unnamed: IC2.13 (-IN), R19.2, R20.1
unnamed: IC2.9 (-IN), R21.1, R22.2
unnamed: IC2.14 (OUT), R20.2, R23.1
unnamed: IC2.8 (OUT), R19.1, R21.2, R24.1
unnamed: D7.C, LEDB4.1, R23.2
unnamed: D8.C, LEDR4.1, R24.2
unnamed: OUT4.1, OUT12.1, R22.1
unnamed: IC3.2 (-IN), R25.1, R26.2
unnamed: IC3.1 (OUT), R25.2, R27.1, R30.1
unnamed: IC3.6 (-IN), R27.2, R28.1
unnamed: OUT5.1, OUT13.1, R26.1
unnamed: IC3.7 (OUT), R28.2, R29.1
unnamed: D9.C, LEDB5.1, R29.2
unnamed: D10.C, LEDR5.1, R30.2
unnamed: IC3.13 (-IN), R31.2, R32.1
unnamed: IC3.9 (-IN), R33.1, R34.2
unnamed: IC3.14 (OUT), R32.2, R35.1
unnamed: IC3.8 (OUT), R31.1, R33.2, R36.1
unnamed: D11.C, LEDB6.1, R35.2
unnamed: D12.C, LEDR6.1, R36.2
unnamed: OUT6.1, OUT14.1, R34.1
unnamed: RATE_POT.1, RATE_POT1.1
unnamed: IC4.2 (-IN), R37.1, R38.2
unnamed: IC4.1 (OUT), R37.2, R39.1, R42.1
unnamed: IC4.6 (-IN), R39.2, R40.1
unnamed: OUT7.1, OUT15.1, R38.1
unnamed: IC4.7 (OUT), R40.2, R41.1
unnamed: D13.C, LEDB7.1, R41.2
unnamed: D14.C, LEDR7.1, R42.2
unnamed: IC4.13 (-IN), R43.2, R44.1
unnamed: IC4.9 (-IN), R45.1, R46.2
unnamed: IC4.14 (OUT), R44.2, R47.1
unnamed: IC4.8 (OUT), R43.1, R45.2, R48.1
unnamed: D15.C, LEDB8.1, R47.2
unnamed: D16.C, LEDR8.1, R48.2
unnamed: OUT8.1, OUT16.1, R46.1
unnamed: RATE_CV.1, RATE_CV1.1
unnamed: GATE_OUT.1, GATE_OUT1.1
unnamed: TRIG_IN.1, TRIG_IN1.1
unnamed: WAVE_CV.1, WAVE_CV1.1
unnamed: LENGTH_CV.1, LENGTH_CV1.1
unnamed: LENGTH_POT.1, LENGTH_POT1.1
unnamed: WAVE_POT.1, WAVE_POT1.1
PE: C1.2, C2.1, C3.2, C4.1, C5.2, C6.1, C7.2, C8.1, D1.A, D2.A, D3.A, D4.A, D5.A, D6.A, D7.A, D8.A, D9.A, D10.A, D11.A, D12.A, D13.A, D14.A, D15.A, D16.A, GND.1, GND1.1, IC1.3 (+IN), IC1.5 (+IN), IC1.10 (+IN), IC1.12 (+IN), IC2.3 (+IN), IC2.5 (+IN), IC2.10 (+IN), IC2.12 (+IN), IC3.3 (+IN), IC3.5 (+IN), IC3.10 (+IN), IC3.12 (+IN), IC4.3 (+IN), IC4.5 (+IN), IC4.10 (+IN), IC4.12 (+IN)
