pigatron-industries/xen_octasource/hardware/mki/PGTN021_octasource_mki_led_drivers.brd

## EAGLE design hardware/mki/PGTN021_octasource_mki_led_drivers.brd (continued)

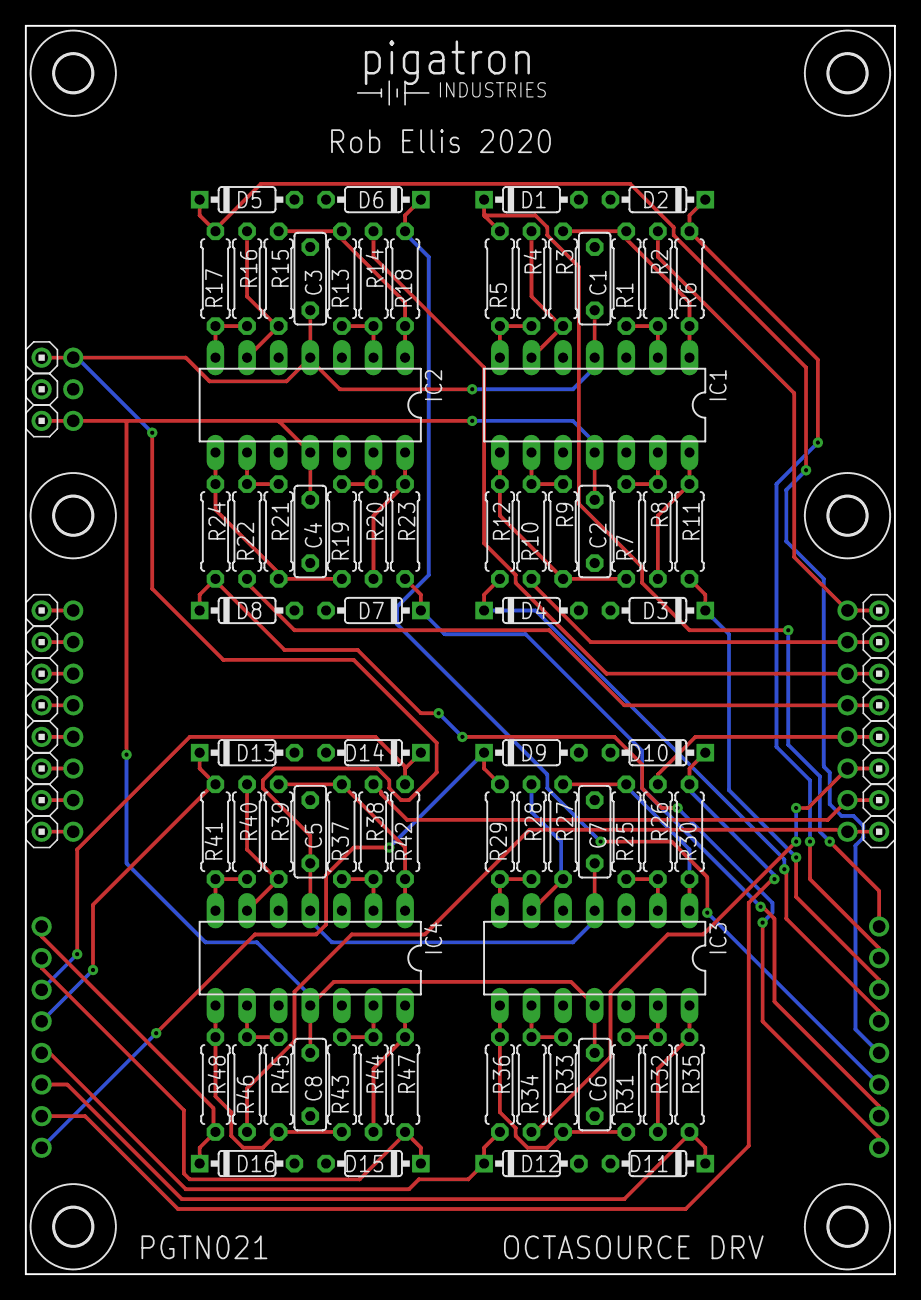
[picture p42: board PGTN021_octasource_mki_led_drivers.brd from above]

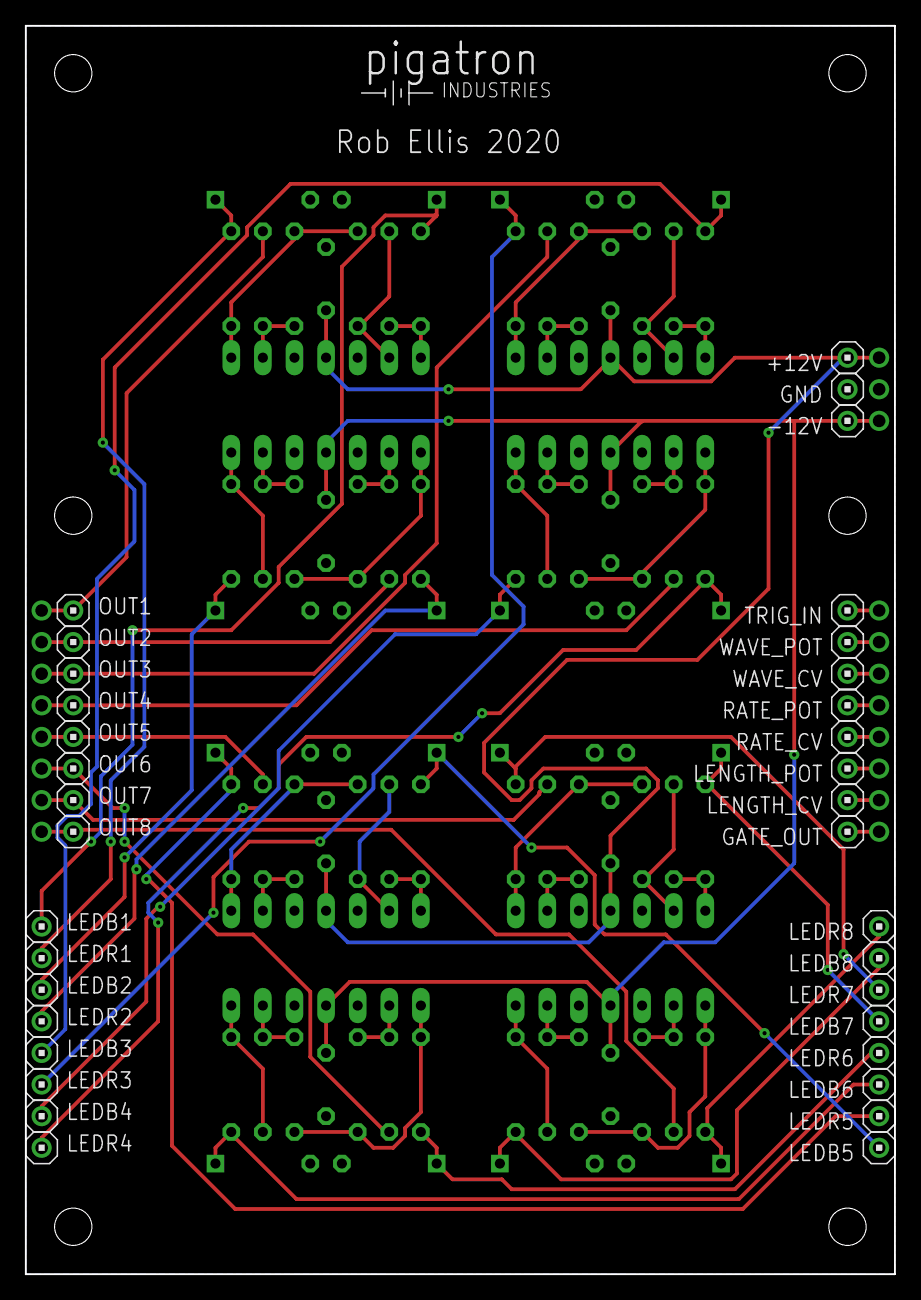
[picture p43: board PGTN021_octasource_mki_led_drivers.brd from below]

Board: 2 copper layers, 69.8 x 100.3 mm, 138 parts (36 on the bottom side), 67 nets.

Other parts of the board:
U$1, U$2: PIGATRON-LOGO
U$4, U$5, U$9, U$10, U$11, U$12: STANDOFF/3.0
