pigatron-industries/xen_octasource/hardware/mki/PGTNX01_teensy.brd

## EAGLE design hardware/mki/PGTNX01_teensy.brd (2020-04-18)

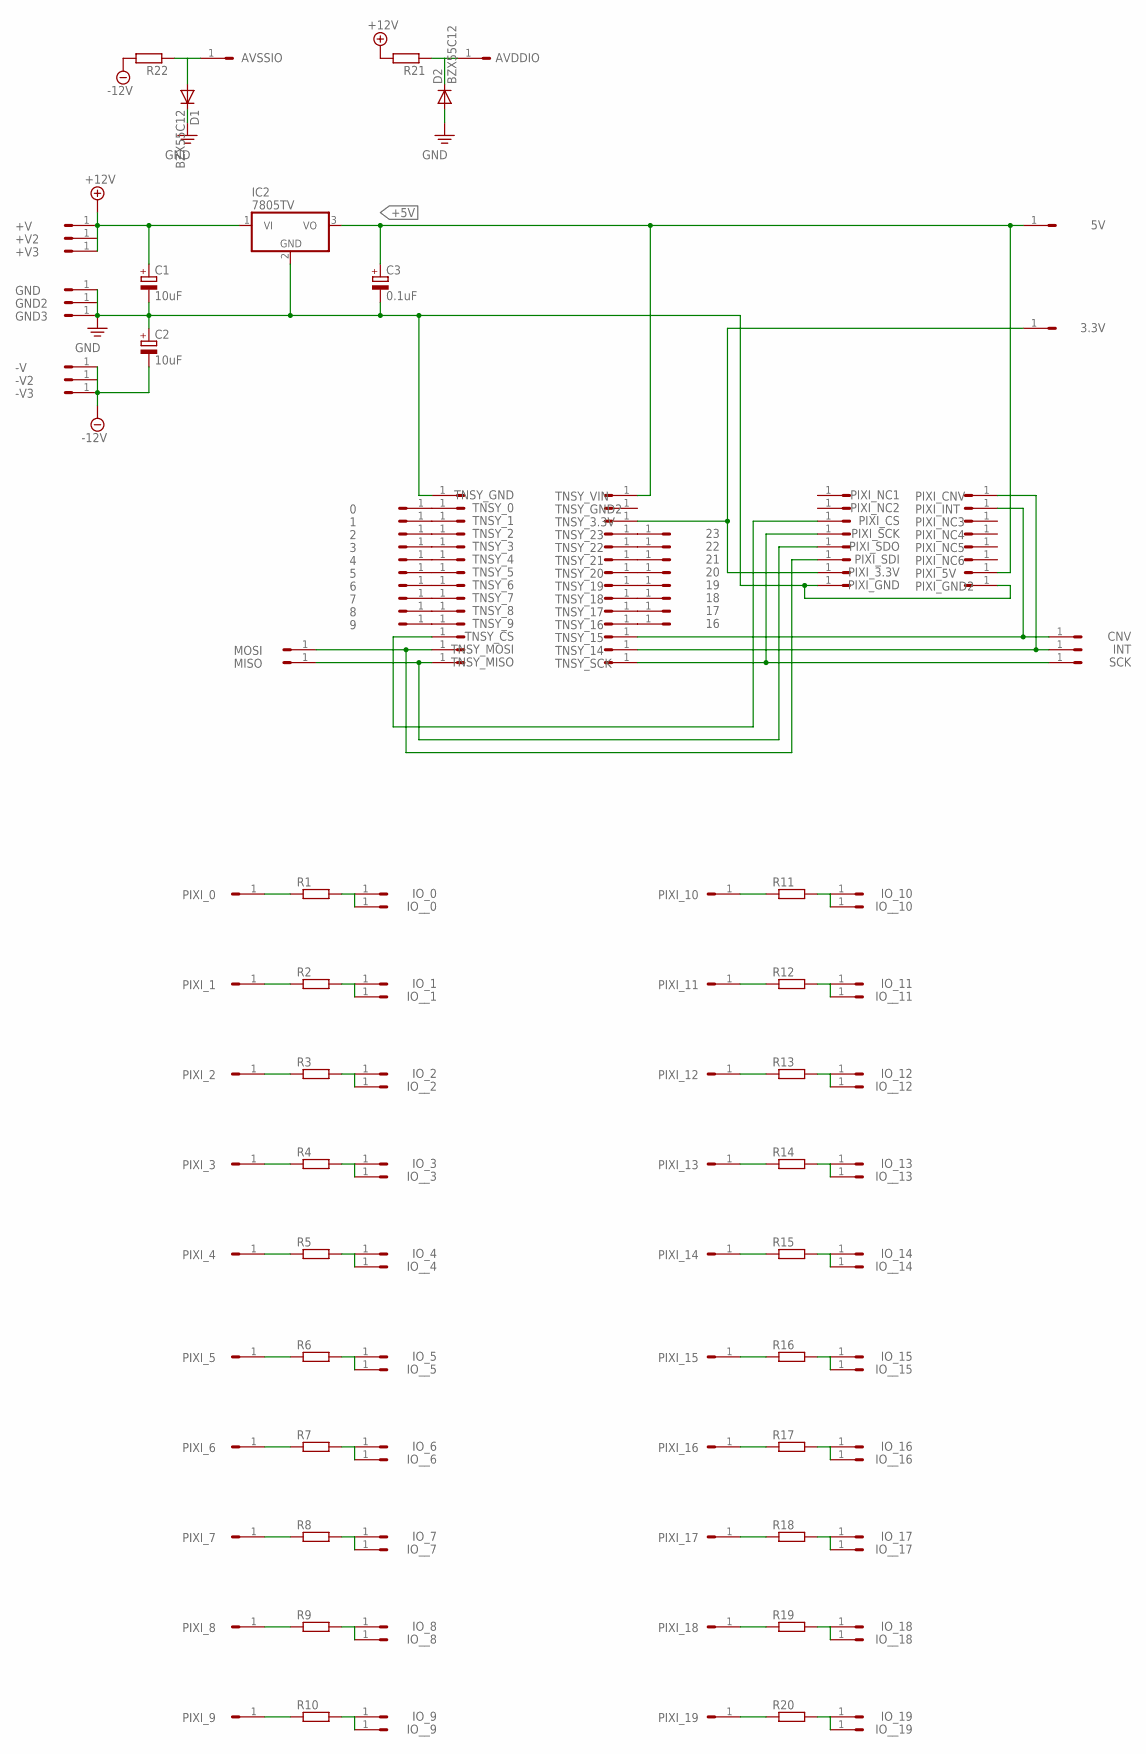
[picture p44: schematic PGTNX01_teensy.sch]

Parts:
0, 1, 2, 3, 3.3V, 4, 5, 5V, 6, 7, 8, 9, 16, 17, 18, 19, 20, 21, 22, 23: HEADER/MALE/01
+V, +V2, +V3: HEADER/MALE/01
-V, -V2, -V3: HEADER/MALE/01
AVDDIO: HEADER/MALE/01
AVSSIO: HEADER/MALE/01
C1, C2: 10uF; E2,5-6
C3: 0.1uF; E2,5-6
CNV: HEADER/MALE/01
D1, D2: BZX55C12; DO35-7
GND, GND2, GND3: HEADER/MALE/01
IC2: 7805TV; TO220V
INT: HEADER/MALE/01
IO_0, IO_1, IO_2, IO_3, IO_4, IO_5, IO_6, IO_7, IO_8, IO_9, IO_10, IO_11, IO_12, IO_13, IO_14, IO_15, IO_16, IO_17, IO_18, IO_19: HEADER/MALE/01
IO__0, IO__1, IO__2, IO__3, IO__4, IO__5, IO__6, IO__7, IO__8, IO__9, IO__10, IO__11, IO__12, IO__13, IO__14, IO__15, IO__16, IO__17, IO__18, IO__19: HEADER/MALE/01
MISO: HEADER/MALE/01
MOSI: HEADER/MALE/01
PIXI_0, PIXI_1, PIXI_2, PIXI_3, PIXI_3.3V, PIXI_4, PIXI_5, PIXI_5V, PIXI_6, PIXI_7, PIXI_8, PIXI_9, PIXI_10, PIXI_11, PIXI_12, PIXI_13, PIXI_14, PIXI_15, PIXI_16, PIXI_17, PIXI_18, PIXI_19: HEADER/MALE/01
PIXI_CNV: HEADER/MALE/01
PIXI_CS: HEADER/MALE/01
PIXI_GND, PIXI_GND2: HEADER/MALE/01
PIXI_INT: HEADER/MALE/01
PIXI_NC1, PIXI_NC2, PIXI_NC3, PIXI_NC4, PIXI_NC5, PIXI_NC6: HEADER/MALE/01
PIXI_SCK: HEADER/MALE/01
PIXI_SDI: HEADER/MALE/01
PIXI_SDO: HEADER/MALE/01
R1, R2, R3, R4, R5, R6, R7, R8, R9, R10, R11, R12, R13, R14, R15, R16, R17, R18, R19, R20, R21, R22: RESISTORRESISTOR/UPRIGHT/7.5; RESISTOR/7.5
SCK: HEADER/MALE/01
TNSY_0, TNSY_1, TNSY_2, TNSY_3, TNSY_3.3V, TNSY_4, TNSY_5, TNSY_6, TNSY_7, TNSY_8, TNSY_9, TNSY_14, TNSY_15, TNSY_16, TNSY_17, TNSY_18, TNSY_19, TNSY_20, TNSY_21, TNSY_22, TNSY_23: HEADER/MALE/01
TNSY_CS: HEADER/MALE/01
TNSY_GND, TNSY_GND2: HEADER/MALE/01
TNSY_MISO: HEADER/MALE/01
TNSY_MOSI: HEADER/MALE/01
TNSY_SCK: HEADER/MALE/01
TNSY_VIN: HEADER/MALE/01

Connections:
+5V: 5V.1, C3.+, IC2.3 (VO), PIXI_5V.1, TNSY_VIN.1
+12V: +V.1, +V2.1, +V3.1, C1.+, IC2.1 (VI), R21.2
-12V: -V.1, -V2.1, -V3.1, C2.-, R22.2
GND: C1.-, C2.+, C3.-, D1.C, D2.A, GND.1, GND2.1, GND3.1, IC2.2 (GND), PIXI_GND.1, PIXI_GND2.1, TNSY_GND.1
unnamed: PIXI_0.1, R1.1
unnamed: 17.1, TNSY_17.1
unnamed: PIXI_1.1, R2.1
unnamed: 16.1, TNSY_16.1
unnamed: MOSI.1, PIXI_SDI.1, TNSY_MOSI.1
unnamed: MISO.1, PIXI_SDO.1, TNSY_MISO.1
unnamed: PIXI_SCK.1, SCK.1, TNSY_SCK.1
unnamed: PIXI_CS.1, TNSY_CS.1
unnamed: INT.1, PIXI_CNV.1, TNSY_14.1
unnamed: CNV.1, PIXI_INT.1, TNSY_15.1
unnamed: 18.1, TNSY_18.1
unnamed: 19.1, TNSY_19.1
unnamed: 20.1, TNSY_20.1
unnamed: 21.1, TNSY_21.1
unnamed: 22.1, TNSY_22.1
unnamed: 23.1, TNSY_23.1
unnamed: 0.1, TNSY_0.1
unnamed: 1.1, TNSY_1.1
unnamed: 2.1, TNSY_2.1
unnamed: 3.1, TNSY_3.1
unnamed: 4.1, TNSY_4.1
unnamed: 5.1, TNSY_5.1
unnamed: 6.1, TNSY_6.1
unnamed: 7.1, TNSY_7.1
unnamed: 8.1, TNSY_8.1
unnamed: 9.1, TNSY_9.1
unnamed: IO_1.1, IO__1.1, R2.2
unnamed: 3.3V.1, PIXI_3.3V.1, TNSY_3.3V.1
unnamed: IO_0.1, IO__0.1, R1.2
unnamed: PIXI_2.1, R3.1
unnamed: IO_2.1, IO__2.1, R3.2
unnamed: PIXI_3.1, R4.1
unnamed: IO_3.1, IO__3.1, R4.2
unnamed: PIXI_4.1, R5.1
unnamed: IO_4.1, IO__4.1, R5.2
unnamed: PIXI_5.1, R6.1
unnamed: IO_5.1, IO__5.1, R6.2
unnamed: PIXI_6.1, R7.1
unnamed: IO_6.1, IO__6.1, R7.2
unnamed: PIXI_7.1, R8.1
unnamed: IO_7.1, IO__7.1, R8.2
unnamed: PIXI_8.1, R9.1
unnamed: IO_8.1, IO__8.1, R9.2
unnamed: PIXI_9.1, R10.1
unnamed: IO_9.1, IO__9.1, R10.2
unnamed: PIXI_10.1, R11.1
unnamed: IO_10.1, IO__10.1, R11.2
unnamed: PIXI_11.1, R12.1
unnamed: IO_11.1, IO__11.1, R12.2
unnamed: PIXI_12.1, R13.1
unnamed: IO_12.1, IO__12.1, R13.2
unnamed: PIXI_13.1, R14.1
unnamed: IO_13.1, IO__13.1, R14.2
unnamed: PIXI_14.1, R15.1
unnamed: IO_14.1, IO__14.1, R15.2
unnamed: PIXI_15.1, R16.1
unnamed: IO_15.1, IO__15.1, R16.2
unnamed: PIXI_16.1, R17.1
unnamed: IO_16.1, IO__16.1, R17.2
unnamed: PIXI_17.1, R18.1
unnamed: IO_17.1, IO__17.1, R18.2
unnamed: PIXI_18.1, R19.1
unnamed: IO_18.1, IO__18.1, R19.2
unnamed: PIXI_19.1, R20.1
unnamed: IO_19.1, IO__19.1, R20.2
unnamed: AVDDIO.1, D2.C, R21.1
unnamed: AVSSIO.1, D1.A, R22.1

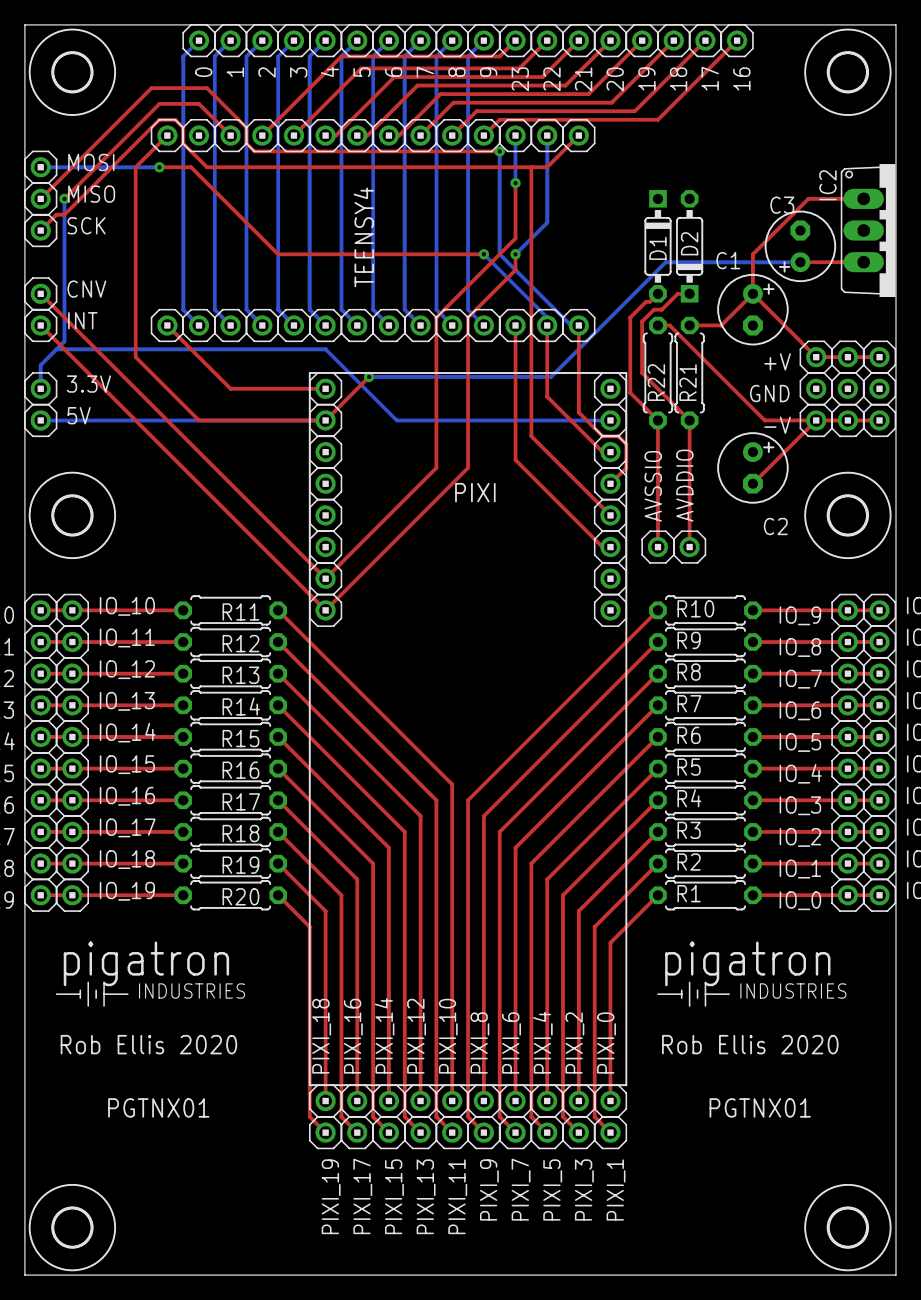
[picture p45: board PGTNX01_teensy.brd from above]

Board: 2 copper layers, 69.9 x 100.3 mm, 176 parts (0 on the bottom side), 71 nets.

Other parts of the board:
U$1, U$2, U$3, U$4, U$6, U$7: STANDOFF/3.0
U$5, U$8: PIGATRON-LOGO
