pigatron-industries/xen_octasource/hardware/temp/PGTN021_octasource2a_controls.brd

## EAGLE design hardware/temp/PGTN021_octasource2a_controls.brd (2021-11-10)

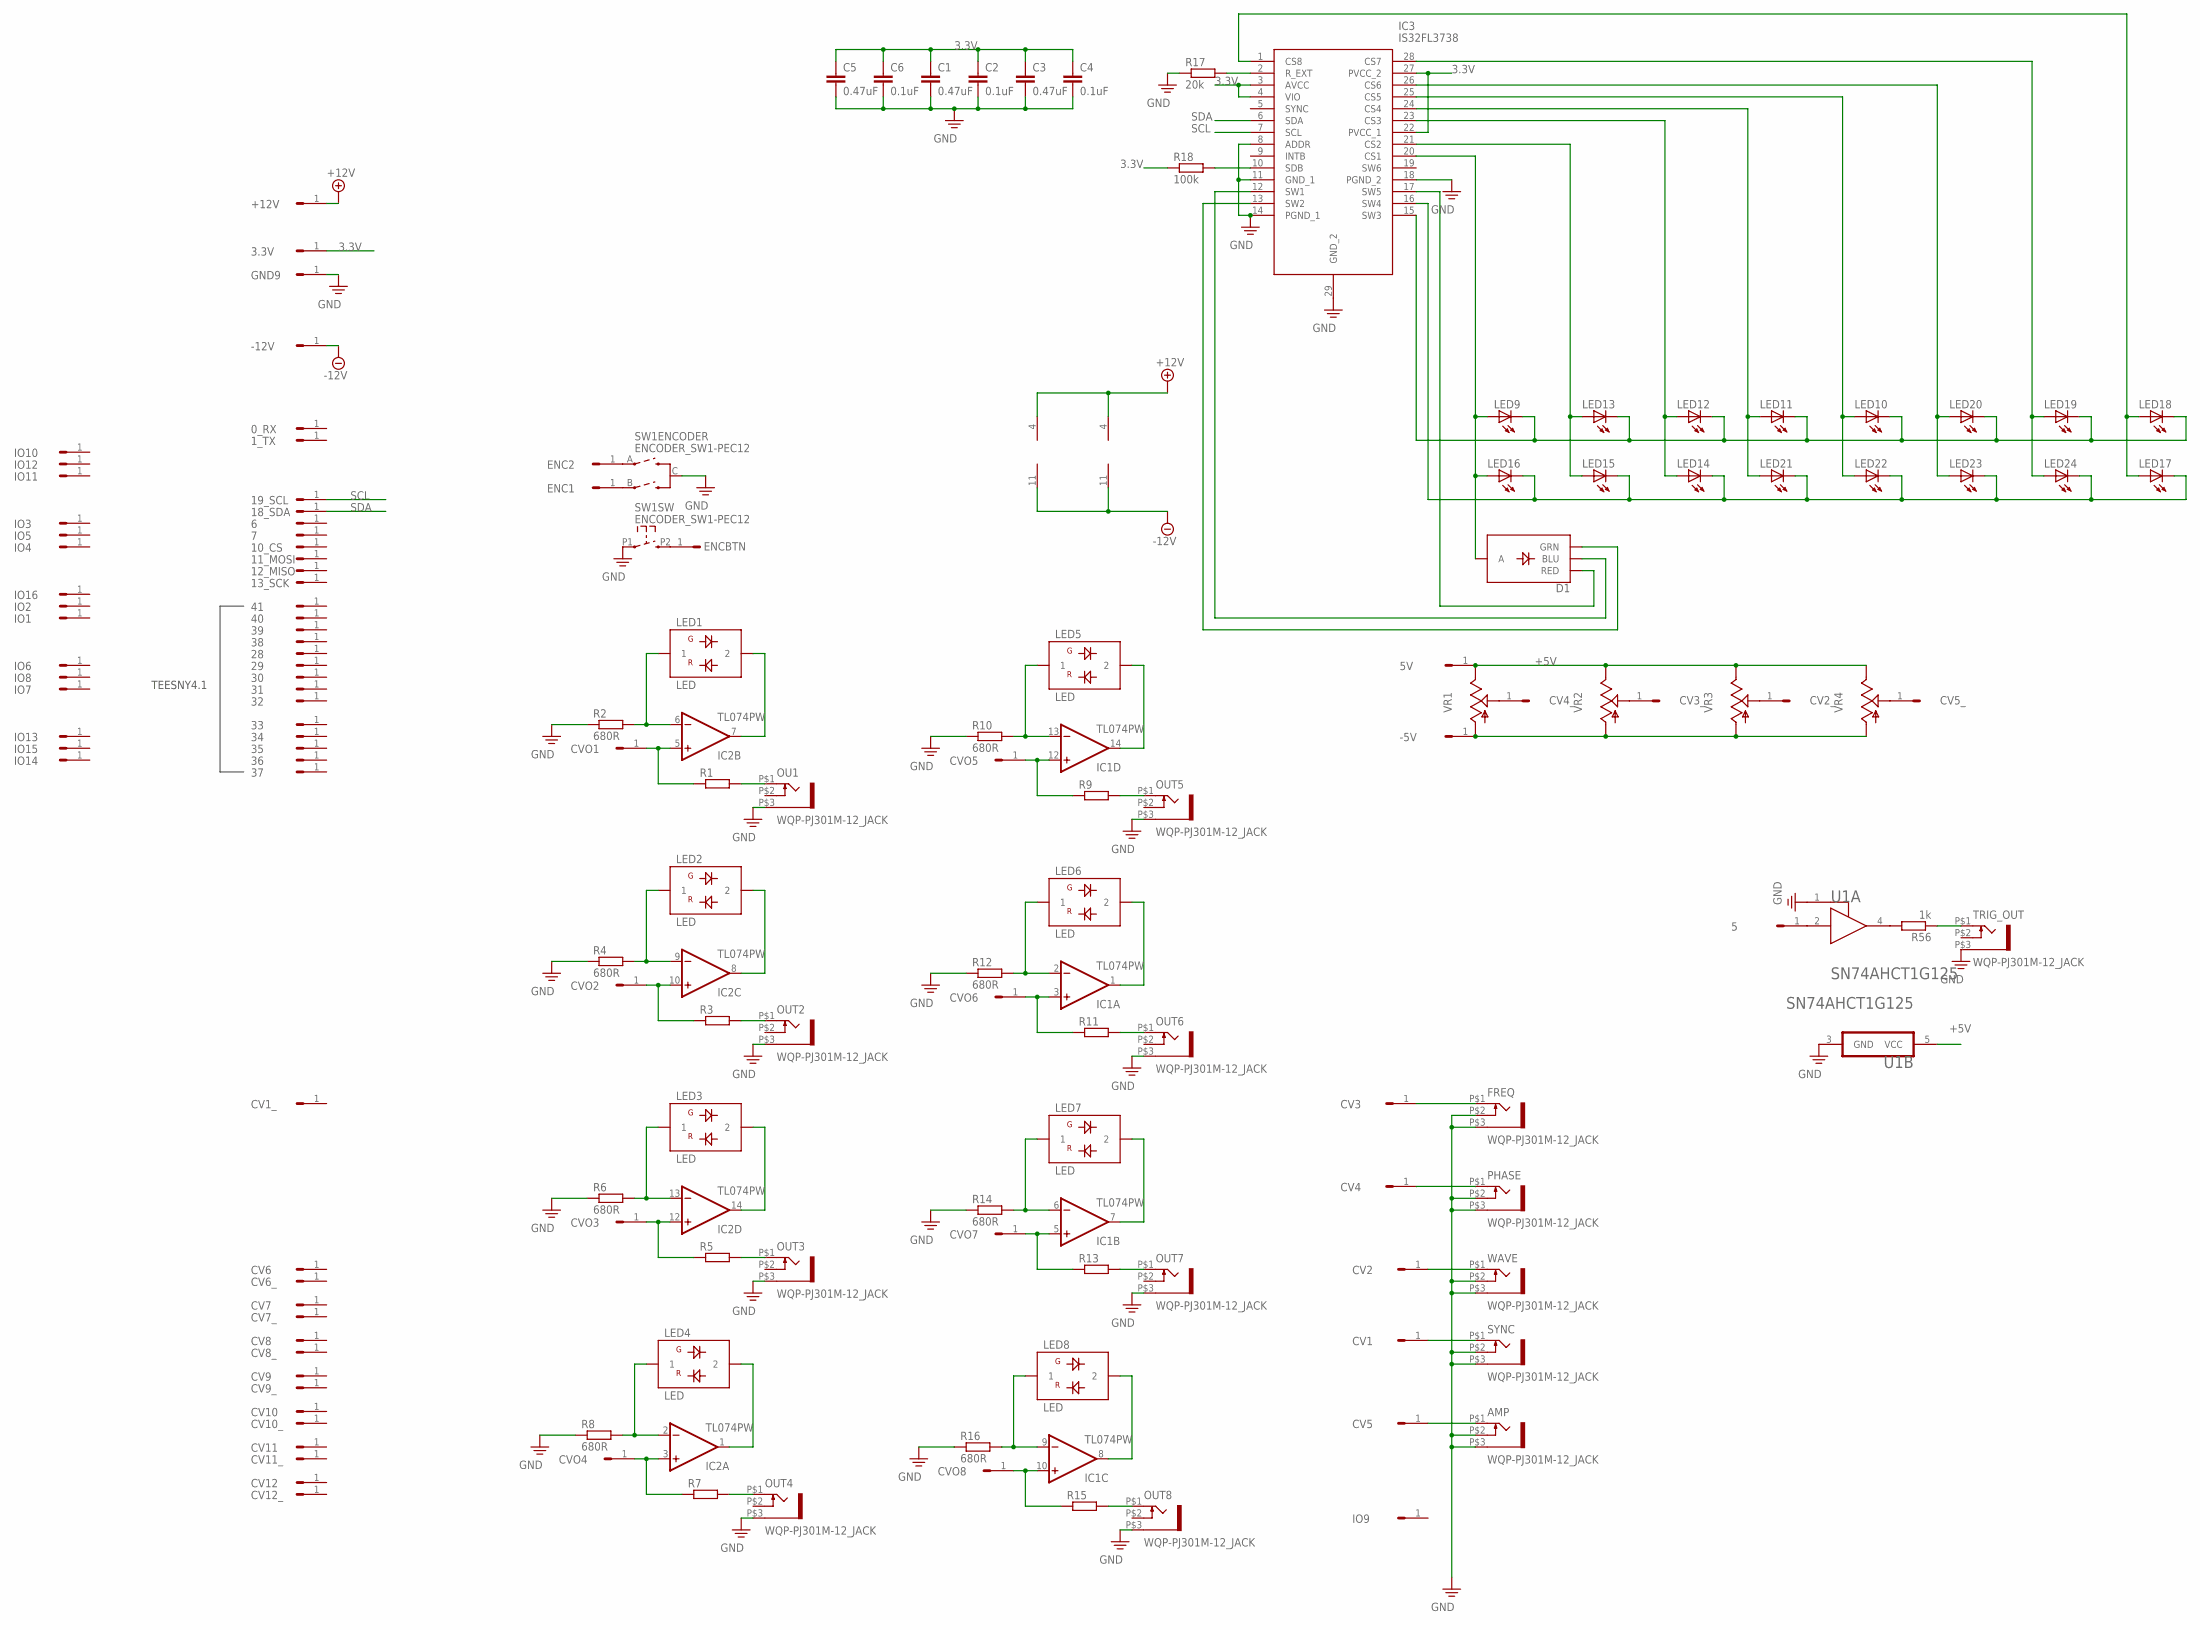
[picture p46: schematic PGTN021_octasource2a_controls.sch]

Parts:
0_RX, 1_TX, 3.3V, 5, 5V, 6, 7, 10_CS, 11_MOSI, 12_MISO, 13_SCK, 18_SDA, 19_SCL, 28, 29, 30, 31, 32, 33, 34, 35, 36, 37, 38, 39, 40, 41: HEADER/MALE/01
+12V: HEADER/MALE/01
-5V, -12V: HEADER/MALE/01
AMP: WQP-PJ301M-12_JACK
C1, C3, C5: 0.47uF; C0603
C2, C4, C6: 0.1uF; C0603
CV1, CV1_, CV2, CV2_, CV3, CV3_, CV4, CV4_, CV5, CV5_, CV6, CV6_, CV7, CV7_, CV8, CV8_, CV9, CV9_, CV10, CV10_, CV11, CV11_, CV12, CV12_: HEADER/MALE/01
CVO1, CVO2, CVO3, CVO4, CVO5, CVO6, CVO7, CVO8: HEADER/MALE/01
D1: LED-RGB-CADIALIGHT1210; CHIPLED_1210
ENC1, ENC2: HEADER/MALE/01
ENCBTN: HEADER/MALE/01
FREQ: WQP-PJ301M-12_JACK
GND9: HEADER/MALE/01
IC1, IC2: TL074PW; TSSOP14
IC3: IS32FL3738; TSSOP29
IO1, IO2, IO3, IO4, IO5, IO6, IO7, IO8, IO9, IO10, IO11, IO12, IO13, IO14, IO15, IO16: HEADER/MALE/01
LED1, LED2, LED3, LED4, LED5, LED6, LED7, LED8: LED; OG-LEDS_LED3MM
LED9, LED10, LED11, LED12, LED13, LED14, LED15, LED16, LED17, LED18, LED19, LED20, LED21, LED22, LED23, LED24: LEDCHIPLED_0805; CHIPLED_0805
OU1: WQP-PJ301M-12_JACK
OUT2, OUT3, OUT4, OUT5, OUT6, OUT7, OUT8: WQP-PJ301M-12_JACK
PHASE: WQP-PJ301M-12_JACK
R1, R3, R5, R7, R9, R11, R13, R15: RESISTOR; R0603
R2, R4, R6, R8, R10, R12, R14, R16: 680R; R0603
R17: 20k; R0603
R18: 100k; R0603
R56: 1k; R0603
SW1: ENCODER_SW1-PEC12; PEC12_INCREMENTAL_ENCODER
SYNC: WQP-PJ301M-12_JACK
TRIG_OUT: WQP-PJ301M-12_JACK
U1: 74AHCT1G125"; 74AHCT1G125
VR1, VR2, VR3, VR4: 9MM_SNAP-IN_POT_; 9MM_SNAP-IN_POT
WAVE: WQP-PJ301M-12_JACK

Connections:
3.3V: 3.3V.1, C1.1, C2.1, C3.1, C4.1, C5.1, C6.1, IC3.3 (AVCC), IC3.4 (VIO), IC3.22 (PVCC_1), IC3.27 (PVCC_2), R18.1
+5V: 5V.1, U1.5 (VCC), VR1.3 (E), VR2.3 (E), VR3.3 (E), VR4.3 (E)
+12V: +12V.1, IC1.4 (V+), IC2.4 (V+)
-12V: -12V.1, IC1.11 (V-), IC2.11 (V-)
unnamed: IC2.6 (-IN), LED1.1, R2.2
unnamed: IC2.7 (OUT), LED1.2
unnamed: CVO1.1, IC2.5 (+IN), R1.1
unnamed: OU1.P$1 (2), R1.2
unnamed: IC2.9 (-IN), LED2.1, R4.2
unnamed: IC2.8 (OUT), LED2.2
unnamed: CVO2.1, IC2.10 (+IN), R3.1
unnamed: OUT2.P$1 (2), R3.2
unnamed: IC2.13 (-IN), LED3.1, R6.2
unnamed: IC2.14 (OUT), LED3.2
unnamed: CVO3.1, IC2.12 (+IN), R5.1
unnamed: OUT3.P$1 (2), R5.2
unnamed: IC2.2 (-IN), LED4.1, R8.2
unnamed: IC2.1 (OUT), LED4.2
unnamed: CVO4.1, IC2.3 (+IN), R7.1
unnamed: OUT4.P$1 (2), R7.2
unnamed: IC1.13 (-IN), LED5.1, R10.2
unnamed: IC1.14 (OUT), LED5.2
unnamed: CVO5.1, IC1.12 (+IN), R9.1
unnamed: OUT5.P$1 (2), R9.2
unnamed: IC1.2 (-IN), LED6.1, R12.2
unnamed: IC1.1 (OUT), LED6.2
unnamed: CVO6.1, IC1.3 (+IN), R11.1
unnamed: OUT6.P$1 (2), R11.2
unnamed: IC1.6 (-IN), LED7.1, R14.2
unnamed: IC1.7 (OUT), LED7.2
unnamed: CVO7.1, IC1.5 (+IN), R13.1
unnamed: OUT7.P$1 (2), R13.2
unnamed: IC1.9 (-IN), LED8.1, R16.2
unnamed: IC1.8 (OUT), LED8.2
unnamed: CVO8.1, IC1.10 (+IN), R15.1
unnamed: OUT8.P$1 (2), R15.2
unnamed: IC3.10 (SDB), R18.2
unnamed: R56.2, U1.4 (Y)
unnamed: 5.1, U1.2 (A)
unnamed: ENCBTN.1, SW1.P2 (2)
unnamed: ENC2.1, SW1.A
unnamed: ENC1.1, SW1.B
unnamed: CV1.1, SYNC.P$1 (2)
unnamed: -5V.1, VR1.1 (A), VR2.1 (A), VR3.1 (A), VR4.1 (A)
unnamed: CV2.1, WAVE.P$1 (2)
unnamed: CV3.1, FREQ.P$1 (2)
unnamed: CV4.1, PHASE.P$1 (2)
unnamed: AMP.P$1 (2), CV5.1
unnamed: CV2_.1, VR3.2 (S)
unnamed: CV3_.1, VR2.2 (S)
unnamed: CV4_.1, VR1.2 (S)
unnamed: CV5_.1, VR4.2 (S)
unnamed: R56.1, TRIG_OUT.P$1 (2)
unnamed: D1.4 (A), IC3.20 (CS1), LED9.A, LED16.A
unnamed: IC3.21 (CS2), LED13.A, LED15.A
unnamed: IC3.23 (CS3), LED12.A, LED14.A
unnamed: D1.2 (RED), IC3.17 (SW5)
unnamed: D1.1 (BLU), IC3.12 (SW1)
unnamed: D1.3 (GRN), IC3.13 (SW2)
unnamed: IC3.16 (SW4), LED14.C, LED15.C, LED16.C, LED17.C, LED21.C, LED22.C, LED23.C, LED24.C
unnamed: IC3.15 (SW3), LED9.C, LED10.C, LED11.C, LED12.C, LED13.C, LED18.C, LED19.C, LED20.C
unnamed: IC3.24 (CS4), LED11.A, LED21.A
unnamed: IC3.25 (CS5), LED10.A, LED22.A
unnamed: IC3.26 (CS6), LED20.A, LED23.A
unnamed: IC3.28 (CS7), LED19.A, LED24.A
unnamed: IC3.1 (CS8), LED17.A, LED18.A
unnamed: IC3.2 (R_EXT), R17.2
PE: AMP.P$2 (3), AMP.P$3 (1), C1.2, C2.2, C3.2, C4.2, C5.2, C6.2, FREQ.P$2 (3), FREQ.P$3 (1), GND9.1, IC3.8 (ADDR), IC3.11 (GND_1), IC3.14 (PGND_1), IC3.18 (PGND_2), IC3.29 (GND_2), OU1.P$3 (1), OUT2.P$3 (1), OUT3.P$3 (1), OUT4.P$3 (1), OUT5.P$3 (1), OUT6.P$3 (1), OUT7.P$3 (1), OUT8.P$3 (1), PHASE.P$2 (3), PHASE.P$3 (1), R2.1, R4.1, R6.1, R8.1, R10.1, R12.1, R14.1, R16.1, R17.1, SW1.C, SW1.P1 (1), SYNC.P$2 (3), SYNC.P$3 (1), TRIG_OUT.P$3 (1), U1.1 (!OE!), U1.3 (GND), WAVE.P$2 (3), WAVE.P$3 (1)
SCL: 19_SCL.1, IC3.7 (SCL)
SDA: 18_SDA.1, IC3.6 (SDA)

Notes on the sheet:
TEESNY4.1

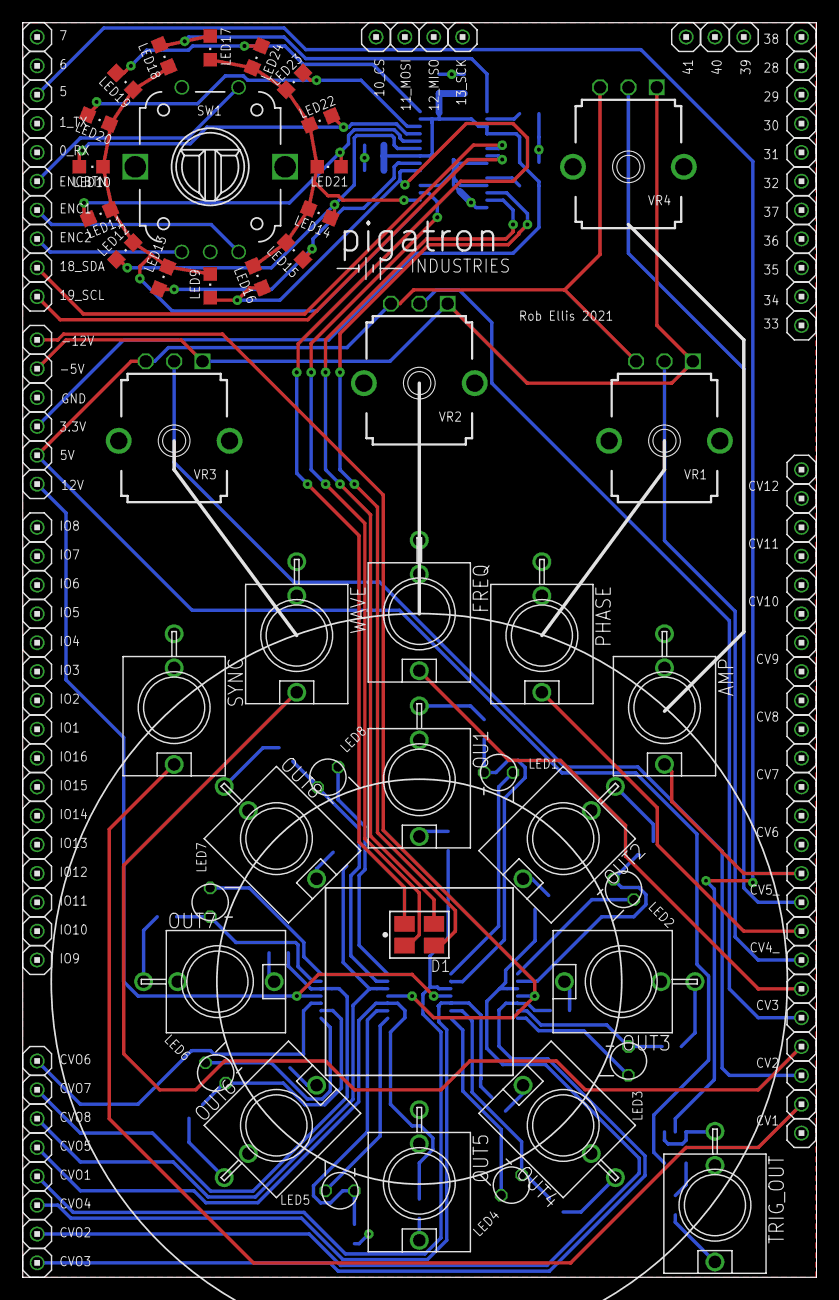
[picture p47: board PGTN021_octasource2a_controls.brd from above]

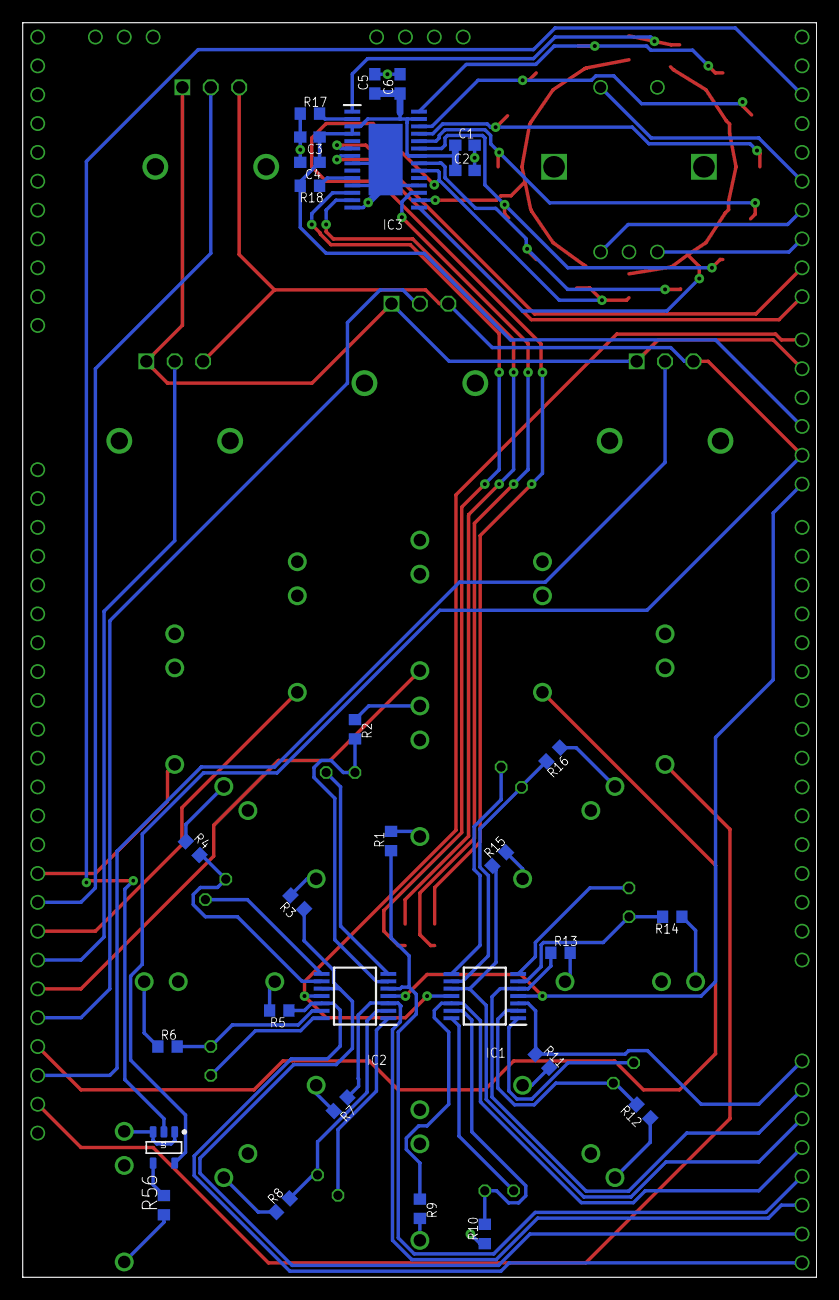
[picture p48: board PGTN021_octasource2a_controls.brd from below]

Board: 2 copper layers, 69.9 x 110.5 mm, 156 parts (29 on the bottom side), 70 nets.

Other parts of the board:
U$1: PIGATRON-LOGO
