pigatron-industries/xen_octasource/src/controllers/clock/ClockController.cpp

#include "ClockController.h"
#include "common/Controls.h"

#define MAX_CLOCK_VALUE NUM_MULTIPLIERS + NUM_DIVIDERS // 15 Multipliers + 15 Dividers
#define DEFAULT_CLOCK_VALUE 15  // 15 = "/1" or unison
#define LOWEST_MULTIPLIER_DIVIDER 2


void ClockController::init(float sampleRate) {
    for(int i = 0; i < 8; i++) {
        this->configParam(i, DEFAULT_CLOCK_VALUE, MAX_CLOCK_VALUE);
    }
    this->configParam(Parameters::PAUSE, (uint8_t)State::RUN, (uint8_t)State::PAUSE);

    ClockedController::init(sampleRate);
    display.init();
    display.focusClock(0);
    clock.setLength(2);

    for(int i = 0; i < NUM_MULTIPLIERS; i++) {
        clockMultipliers[i].init(sampleRate);
    }

    for(int i = 0; i < NUM_DIVIDERS; i++) {
        clockDividers[i].setDivisor(i+2);
    }

    for(int i = 0; i < 8; i++) {
        updateClock(i);
    }

    display.setPause(parameters[Parameters::PAUSE].value == (uint8_t)State::PAUSE);

    init();
}

void ClockController::init() {
    Serial.println("Clock");
    display.render();
    for(int i = 0; i < NUM_DIVIDERS; i++) {
        clockDividers[i].reset();
    }
}

int ClockController::cycleParameter(int amount) {
    parameters.cycle(amount);
    Serial.println(parameters.getSelectedIndex());
    switch(parameters.getSelectedIndex()) {
        case Parameters::PAUSE:
            display.focusPause();
            break;
        default:
            display.focusClock(parameters.getSelectedIndex());
    }
    return parameters.getSelectedIndex(); 
}

void ClockController::cycleValue(int amount) {
    uint8_t parameter = parameters.getSelectedIndex();
    uint8_t value = parameters.getSelected().cycle(amount);  // TODO allow cycling through limited set of values (e.g. lock to powers of 2, or even numbers)

    switch (parameter) {
        case Parameters::PAUSE:
            clock.reset();
            display.setPause(value == (uint8_t)State::PAUSE);
            break;
        default:
            config.data.clock[parameter] = value;
            if(isMultiplier(parameter)) {
                Serial.println("muliplier");
                Serial.println(value);
                Serial.println(getMultiplier(parameter));
                display.setClock(parameter, false, getMultiplier(parameter));
            } else {
                Serial.println("divider");
                Serial.println(value);
                Serial.println(getDivider(parameter));
                display.setClock(parameter, true, getDivider(parameter));
            }
    }
    save();
}

void ClockController::updateClock(uint8_t output) {
    if(isMultiplier(output)) {
        display.setClock(output, false, getMultiplier(output));
    } else {
        display.setClock(output, true, getDivider(output));
    }
}

void ClockController::update() {
    if(ClockedController::updateRate()) {
        updateMultiplierRates();
    }

    if(distortionXCvInput.update()) {
        clock.getFunction().setMidPoint(distortionXCvInput.getValue(), 0.5);
        clock.calculatePhaseIncrements();
    }

    if(lengthInput.update()) {
        clock.setLength(lengthInput.getIntValue());
        updateMultiplierRates();
        display.setLength(lengthInput.getIntValue());
    }

    display.setSource(clock.getState() == InternalExternalClock::State::CLK_INTERNAL ? 0 : 1);
    Hardware::hw.updateOutputLeds(Colour(0, 0, 0), Colour(0, 1, 0));
}

void ClockController::updateMultiplierRates() {
    for(int i = 0; i < NUM_MULTIPLIERS; i++) {
        clockMultipliers[i].setFrequency((clock.getFrequency()/clock.getLength()) * (i+2));
    }
}

void ClockController::process() {
    ClockedController::process();
    triggerOutput.update();

    Array<bool, NUM_MULTIPLIERS> triggers;
    for(int i = 0; i < NUM_MULTIPLIERS; i++) {
        triggers.add(clockMultipliers[i].process());
    }

    for(int i = 0; i < 8; i++) {
        if(isMultiplier(i)) {
            uint8_t multiplierIndex = getMultiplier(i) - LOWEST_MULTIPLIER_DIVIDER;
            if(triggers[multiplierIndex]) {
                // triggerOutputs[i].trigger();
                gateOutputs[i].gate(!gateOutputs[i].getGate());
            }
        }
        // triggerOutputs[i].update();
    }
}

void ClockController::onClock() {
    if(clock.getState() == InternalExternalClock::State::CLK_INTERNAL && parameters[Parameters::PAUSE].value == (uint8_t)State::PAUSE) {
        return;
    }

    syncClocks();
    triggerOutput.trigger();

    for(int i = 0; i < NUM_DIVIDERS; i++) {
        clockDividers[i].tick();
    }

    for(int i = 0; i < 8; i++) {
        uint8_t dividerIndex = getDivider(i) - LOWEST_MULTIPLIER_DIVIDER;
        if(isDivider(i) && clockDividers[dividerIndex].getTrigger()) {
            // divider and divider is triggering this clock cycle
            // triggerOutputs[i].trigger();
            gateOutputs[i].gate(!gateOutputs[i].getGate());
        }
        if(!isDivider(i) && !isMultiplier(i)) {
            // base clock
            // triggerOutputs[i].trigger();
            gateOutputs[i].gate(!gateOutputs[i].getGate());
        }
        if(isMultiplier(i) && clock.getCurrentTick() == 0) {
            // reset multipliers on first tick
            // triggerOutputs[i].trigger();
            gateOutputs[i].gate(!gateOutputs[i].getGate());
        }
    }

    for(int i = 0; i < NUM_DIVIDERS; i++) {
        clockDividers[i].getAndResetTrigger();
    }
}

void ClockController::syncClocks() {
    if(clock.getCurrentTick() == 0) {
        for(int i = 0; i < NUM_MULTIPLIERS; i++) {
            clockMultipliers[i].reset();
        }
    }
}

bool ClockController::isMultiplier(int channel) {
    return parameters[channel].value < NUM_MULTIPLIERS;
}

bool ClockController::isDivider(int channel) {
    return parameters[channel].value > NUM_MULTIPLIERS;
}

uint8_t ClockController::getMultiplier(int channel) {
    return NUM_MULTIPLIERS + 1 - parameters[channel].value;
}

uint8_t ClockController::getDivider(int channel) {
    return parameters[channel].value - NUM_MULTIPLIERS + 1;
}

//  0   1   2   3   4   5   6    7   8   9   10  11  12  13  14  15  16  17  18  19  20  21  22  23  24  25  26  27  28  29 30
// *16 *15 *14 *13 *12 *11 *10  *9  *8  *7  *6  *5  *4  *3  *2   1  /2  /3  /4  /5  /6  /7  /8  /9  /10 /11 /12 /13 /14 /15 /16
