pigatron-industries/xen_octasource/src/controllers/ClockMultiplierController.h

#ifndef ClockMultiplierController_h
#define ClockMultiplierController_h

#include "Controller.h"

using namespace eurorack;

#define SAMPLERATE_DIVIDER 8

class ClockMultiplierController : public Controller {
    public:
        enum Mode {
            NORMAL
        };

        ClockMultiplierController() : Controller(Mode::NORMAL) {}
        virtual void init(float sampleRate);
        virtual void init();
        virtual void update();
        virtual void process();

    private:
        AnalogGateInput<AnalogInputPinT> syncInput = AnalogGateInput<AnalogInputPinT>(Hardware::hw.syncCvPin);
        LinearInput<AnalogInputSumPinT> rateCvInput = LinearInput<AnalogInputSumPinT>(Hardware::hw.rateSumPin, -5, 5, 0, 1);
        IntegerInput<AnalogInputSumPinT> syncMultCvInput = IntegerInput<AnalogInputSumPinT>(Hardware::hw.rateSumPin, -5.0, 5.0, -7, 7);
        //LinearInput<AnalogInputSumPinT> lengthInput = LinearInput<AnalogInputSumPinT>(Hardware::hw.ampSumPin, -5, 5, 4.1, 32.9);
        IntegerInput<AnalogInputSumPinT> rotateInput = IntegerInput<AnalogInputSumPinT>(Hardware::hw.waveSumPin, -5, 5, 0, 8);
        #if defined(OCTASOURCE_MKII)
            //LinearInput<AnalogInputSumPinT> distortionYCvInput = LinearInput<AnalogInputSumPinT>(Hardware::hw.phaseSumPin, -5, 5, 0, 1);
            GateInput<> rangeInput = GateInput<>(Hardware::hw.rangeSwitchPin, false);
        #endif

        AnalogTriggerOutput<AnalogOutputDeviceT> triggerOutputs[8] = {
            AnalogTriggerOutput<AnalogOutputDeviceT>(*Hardware::hw.cvOutputPins[0]),
            AnalogTriggerOutput<AnalogOutputDeviceT>(*Hardware::hw.cvOutputPins[1]),
            AnalogTriggerOutput<AnalogOutputDeviceT>(*Hardware::hw.cvOutputPins[2]),
            AnalogTriggerOutput<AnalogOutputDeviceT>(*Hardware::hw.cvOutputPins[3]),
            AnalogTriggerOutput<AnalogOutputDeviceT>(*Hardware::hw.cvOutputPins[4]),
            AnalogTriggerOutput<AnalogOutputDeviceT>(*Hardware::hw.cvOutputPins[5]),
            AnalogTriggerOutput<AnalogOutputDeviceT>(*Hardware::hw.cvOutputPins[6]),
            AnalogTriggerOutput<AnalogOutputDeviceT>(*Hardware::hw.cvOutputPins[7])
        };
        TriggerOutput<DigitalOutputDeviceT> triggerOutput = TriggerOutput<DigitalOutputDeviceT>(Hardware::hw.gateOutPin, 20000);

        Clock clocks[9];
        Clock mainClock;
        ClockDivider clockDivider = ClockDivider(SAMPLERATE_DIVIDER);

        float syncFrequency;
        int rotation = 0;

        void updateRate(bool force = false);
        void updateRotation();
        void setRates(float frequency);
        void updateRange();
        void updateSync();
        void syncClocks();
};

#endif
