pigatron-industries/xen_octasource/src/display/Display.cpp

#include "Display.h"
#include <eurorack.h>

void Display::init() {
    u8g2.begin();
    u8g2.clearBuffer();	
    u8g2.sendBuffer();
}

void Display::clear() {
    u8g2.clearBuffer();
}

void Display::update() {
    u8g2.sendBuffer();
}

void Display::text(const char* text, uint8_t x, uint8_t y, uint8_t w) {
    u8g2.setFont(DISPLAY_FONT);
    u8g2.setDrawColor(0);
    u8g2.drawBox(y, x, w, DISPLAY_FONT_HEIGHT);
    u8g2.setDrawColor(1);
    u8g2.drawStr(y, x+DISPLAY_FONT_HEIGHT-1, text);
    u8g2.sendBuffer();
}

void Display::text(int num, uint8_t x, uint8_t y, uint8_t w) {
    snprintf_P(buffer, sizeof(buffer), PSTR("%d"), num);
    text(buffer, x, y, w);
}

void Display::drawWaveShape(WaveShape* waveShape, uint8_t x, uint8_t y, uint8_t width, uint8_t height, uint8_t n, bool bipolar) {
    u8g2.setDrawColor(0);
    u8g2.drawBox(x, y, width*n, height);
    u8g2.setDrawColor(1);

    float phaseInc = 1.0/float(width);
    float phase = 0;
    RangeScale scale = RangeScale(bipolar ? -1 : 0, 1, 0, height-2);

    for(uint8_t i = 0; i < width; i++) {
        float value = waveShape->get(phase);
        uint8_t pixelValue = scale.convert(value);

        for(int j = 0; j < n; j++) {
            uint8_t nx = x+(width*j);
            u8g2.drawPixel(nx+i, y+pixelValue);
        }

        phase += phaseInc;
    }
}
