pigatron-industries/xen_octasource/src/display/OLEDDisplay.h

#ifndef Display_h
#define Display_h

#include <SPI.h>
#include <Wire.h>
#include <U8g2lib.h>
#include <eurorack_dsp.h>
#include <eurorack_graphics.h>
#include "PixelTrail.h"

using namespace eurorack;

#define DISPLAY_WIDTH 64
#define DISPLAY_HEIGHT 32

#define DISPLAY_FONT u8g2_font_5x7_mf
#define DISPLAY_FONT_HEIGHT 7
#define DISPLAY_FONT_WIDTH 5

#define OLED_BLACK 0
#define OLED_WHITE 1

class OLEDDisplay : public GraphicsContext {
    public:
        static const uint16_t WIDTH = DISPLAY_WIDTH;
        static const uint16_t HEIGHT = DISPLAY_HEIGHT;

        static const uint16_t DEF_COLOUR_TEXT = OLED_WHITE;
        static const uint16_t DEF_COLOUR_BACK = OLED_BLACK;
        static const uint16_t DEF_COLOUR_FOCUS_TEXT = OLED_BLACK;
        static const uint16_t DEF_COLOUR_FOCUS_BACK = OLED_WHITE;

        OLEDDisplay() {}
        void init();

        void clear();
        void update();

        // display info
        uint16_t getWidth() { return WIDTH; }
        uint16_t getHeight() { return HEIGHT; }

        // fonts
        void setFont(uint8_t font) {};
        uint16_t getFontHeight(uint8_t font) { return DISPLAY_FONT_HEIGHT; }
        uint16_t getFontWidth(uint8_t font) { return DISPLAY_FONT_WIDTH; }

        // colours
        void setTextColour(uint16_t colour);

        // text
        void text(const char* text, uint8_t x = 0, uint8_t y = 0);

        // shapes
        void fillRectangle(int x, int y, int w, int h, int colour);
        void drawRectangle(int x, int y, int w, int h, int colour);



        void textLine(const char* text, uint8_t x = TEXTLINE_1, uint8_t y = 0, uint8_t w = DISPLAY_WIDTH);// Deprecated
        void textLine(int num, uint8_t x = TEXTLINE_1, uint8_t y = 0, uint8_t w = DISPLAY_WIDTH);// Deprecated

        //TODO move to component
        void drawWaveShape(WaveShape* waveShape, uint8_t x, uint8_t y, uint8_t width, uint8_t height, uint8_t n = 1, bool bipolar = true);
        template<int N>
        void drawPixelTrail(PixelTrail<N>& trail, Pixel pixel); 

    
        static constexpr uint8_t LINE_HEIGHT = DISPLAY_FONT_HEIGHT+1;
        static constexpr uint8_t TEXTLINE_1 = 0;
        static constexpr uint8_t TEXTLINE_2 = LINE_HEIGHT;
        static constexpr uint8_t TEXTLINE_3 = LINE_HEIGHT*2;
        static constexpr uint8_t TEXTLINE_4 = LINE_HEIGHT*3;
    
    protected: 
        U8G2_SSD1306_64X32_1F_F_HW_I2C u8g2 = U8G2_SSD1306_64X32_1F_F_HW_I2C(U8G2_R0, U8X8_PIN_NONE);

        char buffer[13];
};


template<int N>
void OLEDDisplay::drawPixelTrail(PixelTrail<N>& trail, Pixel newPixel) {
    Pixel prevPixel = trail.getPrev();
    if(prevPixel.x != newPixel.x || prevPixel.y != newPixel.y) {
        Pixel lastPixel = trail.push(newPixel);
        u8g2.setDrawColor(0);
        u8g2.drawPixel(lastPixel.x, lastPixel.y);
        u8g2.setDrawColor(1);
        u8g2.drawPixel(newPixel.x, newPixel.y);        
    }
}

#endif
