pigatron-industries/xen_octasource/src/controllers/clock/ClockDisplay.h

#ifndef ClockDisplay_h
#define ClockDisplay_h

#include <eurorack_graphics.h>
#include "Hardware.h"

class ClockDisplay {
    public:
        ClockDisplay() {}
        void init();
        void render();

        void focusClock(uint8_t output);
        void focusPause();
        void setClock(uint8_t output, bool divide, uint8_t value);
        void setLength(uint8_t length);
        void setPause(bool pause);
        void setSource(uint8_t source);

    private:
        FocusManager<OLEDDisplay> focusManager;

        VerticalContainer<OLEDDisplay, 4> page;
        TextComponent<OLEDDisplay> title = TextComponent<OLEDDisplay>(OLEDDisplay::WIDTH, "CLOCK", 2);

        HorizontalContainer<OLEDDisplay, 4> clockRow1;
        HorizontalContainer<OLEDDisplay, 4> clockRow2;
        FieldComponent<OLEDDisplay> clockFields[8] = {
            FieldComponent<OLEDDisplay>(OLEDDisplay::WIDTH/4, 0, ""),
            FieldComponent<OLEDDisplay>(OLEDDisplay::WIDTH/4, 0, ""),
            FieldComponent<OLEDDisplay>(OLEDDisplay::WIDTH/4, 0, ""),
            FieldComponent<OLEDDisplay>(OLEDDisplay::WIDTH/4, 0, ""),
            FieldComponent<OLEDDisplay>(OLEDDisplay::WIDTH/4, 0, ""),
            FieldComponent<OLEDDisplay>(OLEDDisplay::WIDTH/4, 0, ""),
            FieldComponent<OLEDDisplay>(OLEDDisplay::WIDTH/4, 0, ""),
            FieldComponent<OLEDDisplay>(OLEDDisplay::WIDTH/4, 0, "")
        };
        HorizontalContainer<OLEDDisplay, 3> clockRow3;
        FieldComponent<OLEDDisplay> lengthField = FieldComponent<OLEDDisplay>(OLEDDisplay::WIDTH/3, 0);
        FieldComponent<OLEDDisplay> pauseField = FieldComponent<OLEDDisplay>(OLEDDisplay::WIDTH/3, 0);
        FieldComponent<OLEDDisplay> sourceField = FieldComponent<OLEDDisplay>(OLEDDisplay::WIDTH/3, 0);
};

#endif
