pigatron-industries/xen_octasource/src/systems/continuous/attractor/HalvorsenAttractor.h

#ifndef HalvorsenAttractor_h
#define HalvorsenAttractor_h

#include "../ContinuousSystem.h"

class HalvorsenAttractor : public ContinuousSystemN<3> {
    public:
        void init(float sampleRate) {
            ContinuousSystemN::init(sampleRate);
            pos[X] = 0.1;
            pos[Y] = 0.1;
            pos[Z] = 0.1;
            mult[X] = 0.4;
            mult[Y] = 0.5;
            mult[Z] = 0.5;
            offset[X] = 2.75;
            offset[Y] = 3;
            offset[Z] = 2.75;
            speedMult = 5;
            initParams(
                {1.4}, 
                {3.5}
            );
        }

        const char* getName() { return "HALVORSEN"; }

        void system() {
            delta[X] = -PA*pos[X] - 4*pos[Y] - 4*pos[Z] - pos[Y]*pos[Y];
            delta[Y] = -PA*pos[Y] - 4*pos[Z] - 4*pos[X] - pos[Z]*pos[Z];
            delta[Z] = -PA*pos[Z] - 4*pos[X] - 4*pos[Y] - pos[X]*pos[X];
        }

};

#endif
