pigatron-industries/xen_octasource/src/display/ParameterPage.cpp

#include "ParameterPage.h"

void ParameterPage::setLabel(int line, const char* text) {
    Hardware::hw.display.textLine(text, OLEDDisplay::LINE_HEIGHT*line, DISPLAY_FONT_WIDTH);
}

void ParameterPage::setValue(int line, int value) {
    Hardware::hw.display.textLine(value, OLEDDisplay::LINE_HEIGHT*line, DISPLAY_FONT_WIDTH*valueStart);
}

void ParameterPage::selectLine(int line) {
    Hardware::hw.display.textLine(" ", OLEDDisplay::LINE_HEIGHT*selectedLine, 0, DISPLAY_FONT_WIDTH);
    selectedLine = line;
    Hardware::hw.display.textLine(">", OLEDDisplay::LINE_HEIGHT*selectedLine, 0, DISPLAY_FONT_WIDTH);
}
