pigatron-industries/xen_octasource/src/tasks/InputTask.h

#ifndef InputTask_h
#define InputTask_h

#include <Bounce2.h>
#include <Encoder.h>

#include <inttypes.h>

#include "../lib/io/AbstractInputTask.h"
#include "../lib/io/Timer.h"
#include "../modules/OctaSource.h"

#define CALIBRATED_POT_SIZE 3


class InputTask : public AbstractInputTask {

public:
    InputTask(CvInputOutput& cvInputOutput, OctaSource& octasource);
    void init();
    void execute();

private:
    OctaSource& _octasource;

    Bounce _modeSwitch;
    Encoder _modeEncoder;
    long _encoderMovement;

    GateInput _trigger;
    bool _slaveMode;
    Timer _transmitTimer;

    float rateVoltageToFrequency(float voltage);
    void switchMode();
    void switchSlaveMode();
    void printMode();

    void sendData();
    float receiveData();

};

#endif
