pigatron-industries/xen_octasource/(commit log)

2020-01-26 Simplified for single MAX11300 device
2020-01-26 Set MAX11300 to immediate update mode. Increases sample rate of DAC output
2020-02-16 Moved oscillator into moduels directory
    [main.cpp]
2020-02-20 Moved pin mode settings to OutputTask
2020-02-20 Moved pin mode setings to InputTask and OutputTask
2020-02-20 Added pin number constants
2020-02-20 Wired up input and output with octasource class
2020-02-22 Convert voltage to frequency
2020-02-22 Fixed voltage conversion and negative frequency handling
2020-02-22 Added pot calibration (hard coded)
2020-02-22 Output all 8 oscillators
    [InputTask.cpp]
2020-02-23 Added amplitude control and prevent float overflow when turning on
    [InputTask.cpp, InputTask.h]
2020-02-23 calibrated amplitude
2020-03-14 Added calibration mode
2020-03-14 Added calibration mode to AbstractInputTask
2020-03-14 Initialiser for pot calibration
2020-03-14 Added hard coded pot calibration
2020-03-14 move pot calibration to abstract class
2020-03-14 Pot calibration sequence
2020-03-15 Load and save calibration.
2020-03-15 Load and save calibration
2020-03-15 Made mode switch switch mode with debounce
2020-03-21 Added rate CV as offset to pot voltage
2020-03-21 Don't use calibrated value for cv
2020-03-22 Added prototype photos
2020-03-22 Made trigger input reset state of all modes
    [InputTask.cpp, InputTask.h]
2020-03-22 Added hardware design files
    [PGTN021_octasource_controls.brd, PGTN021_octasource_controls.sch, PGTN021_octasource_drivers.brd, PGTN021_octasource_drivers.sch]
2020-03-22 added teensy io schematic and board
    [PGTN021_octasource_led_drivers.brd, PGTN021_octasource_led_drivers.sch, PGTNX01_teensy.brd, PGTNX01_teensy.sch]
2020-03-28 Updated pins numbers for new pcb design
2020-04-03 Changed resistor values to 39k
    [PGTN021_octasource_controls.brd, PGTN021_octasource_controls.sch]
2020-04-04 added capacitor values
    [PGTN021_octasource_led_drivers.brd, PGTN021_octasource_led_drivers.sch]
2020-04-18 Added correct diode type BZX55C12
    [PGTNX01_teensy.brd, PGTNX01_teensy.sch]
2020-05-24 Added rotary encoder to be able to set a submode for each mode.
2021-05-22 Use MAX11300 lib from Arduino Eurorack
2021-05-31 eagle version
    [PGTN021_octasource_controls.brd]
2021-09-04 Removed setting pin types as it's done by library
2021-10-02 Octosource MKII hardware and software
    [PGTN021_octasource_mki_controls.brd, PGTN021_octasource_mki_controls.sch, PGTN021_octasource_mki_led_drivers.brd, PGTN021_octasource_mki_led_drivers.sch, PGTN021_octasource_mkii_controls.brd, PGTN021_octasource_mkii_controls.sch]
2021-10-03 Filtered LFO
2021-11-07 Reset controller by pressing button
    [MainController.cpp, MainController.h]
2021-11-07 maximum velocity
2021-11-07 removed println
2021-11-10 renamed Tuple to Vector
    [PGTN021_octasource2a_controls.brd, PGTN021_octasource2a_controls.sch, PGTN021_octasource2b_controls.brd, PGTN021_octasource2b_controls.sch, PGTN021_octasource2c_controls.brd, PGTN021_octasource2c_controls.sch]
2021-11-13 output leds
2021-11-15 Moved hardware
    [PGTN021_octasource_mki_controls.brd, PGTN021_octasource_mki_controls.sch, PGTN021_octasource_mki_led_drivers.brd, PGTN021_octasource_mki_led_drivers.sch, PGTN021_octasource_mkii_controls.brd, PGTN021_octasource_mkii_controls.sch, PGTNX01_teensy.brd, PGTNX01_teensy.sch]
2021-11-20 Run double pendulum at reduced sample rate
2021-11-21 Add more controllers, fixed MKI
    [ClockController.cpp, ClockController.h, EnvelopeController.cpp, EnvelopeController.h, FilterController.cpp, FilterController.h, Hardware.h, MainController.h]
2021-12-05 trigger rebounces the ball based on current height
2021-12-12 power of 2 clock divider
2021-12-18 Sloppiness control on clock
    [PGTN021_octasource_mkiii_controls.brd, PGTN021_octasource_mkiii_controls.sch, PGTN021_octasource_mkiii_panel.brd, PGTN021_octasource_mkiii_panel.sch, PGTN021_octasource_mkiii_panel_b.brd, PGTN021_octasource_mkiii_panel_b.sch]
2021-12-21 moved functions to update output leds
2021-12-24 Random mode with noise and random trigger outputs
    [RandomController.cpp, RandomController.h, main.cpp]
2021-12-24 Added random voltage
2022-01-16 Switch between internal and external clock
2022-01-30 REplaced WaveList with WaveSelector
    [FilterController.h, FrequencyController.cpp, FrequencyController.h, PhasedController.cpp, PhasedController.h]
2022-02-01 Replaced ControllerList with ObjectSelector
    [MainController.cpp]
2022-02-09 Specify Input Device
2022-02-19 light leds according to amountof distortion
2022-02-19 Final mkiii hardware
    [PGTN021_octasource_mkiii_controls.brd, PGTN021_octasource_mkiii_controls.sch, PGTN021_octasource_mkiii_panel.brd, PGTN021_octasource_mkiii_panel.sch, PGTN021_octasource_mkiii_panel_b.brd, PGTN021_octasource_mkiii_panel_b.sch]
2022-03-06 Filter and Clock Divider doc
2022-03-14 fixed issues casued by lib update
    [ClockController.h, Hardware.cpp, Vector.h]
2022-03-21 Add SDB pin
2022-03-25 Sum pin value from pots and cvs
2022-03-28 Code for range switch
2022-04-08 Spring pendulum using simple physics engine
2022-04-10 Added note about rgb leds
2022-04-10 spring pendulum tweaks
2022-05-30 add photo of mkii
    [PGTN021_octasource_mkiii_controls.brd, PGTN021_octasource_mkiii_controls.sch, PGTN021_octasource_mkiii_panel.brd]
2022-07-09 Analog output calibration
2023-07-14 rename single encoder controller
2023-10-28 add pcb designs to BOM
    [PGTN021_octasource_mkiii_controls.brd, PGTN021_octasource_mkiii_panel.brd]
2023-10-28 add missing LM4040 from bom
2024-03-31 pendulum oscilliscope mode + fixes
    [Hardware.cpp, Hardware.h, PendulumController.cpp, PendulumController.h]
2024-05-18 add teensy 4.1 variant
2024-09-08 blank leds when changing mode
