pigatron-industries/xen_octasource/docs/images/build/Photo 23-04-2022, 18 10 59.jpg

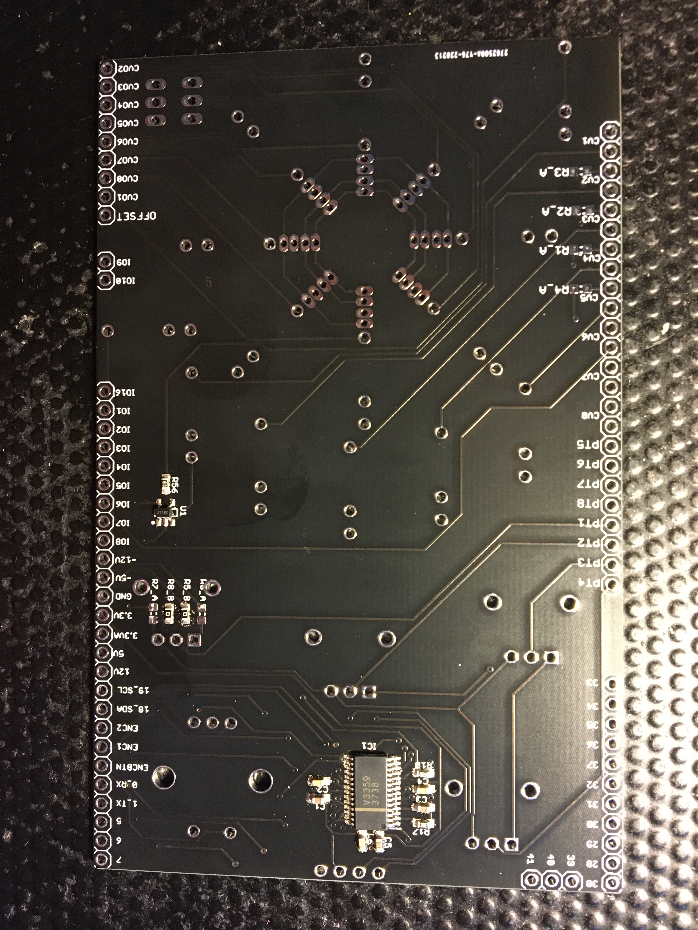
docs/images/build/Photo 23-04-2022, 18 10 59.jpg
