pigatron-industries/xen_octasource/docs/images/build/Photo 23-04-2022, 18 36 19.jpg

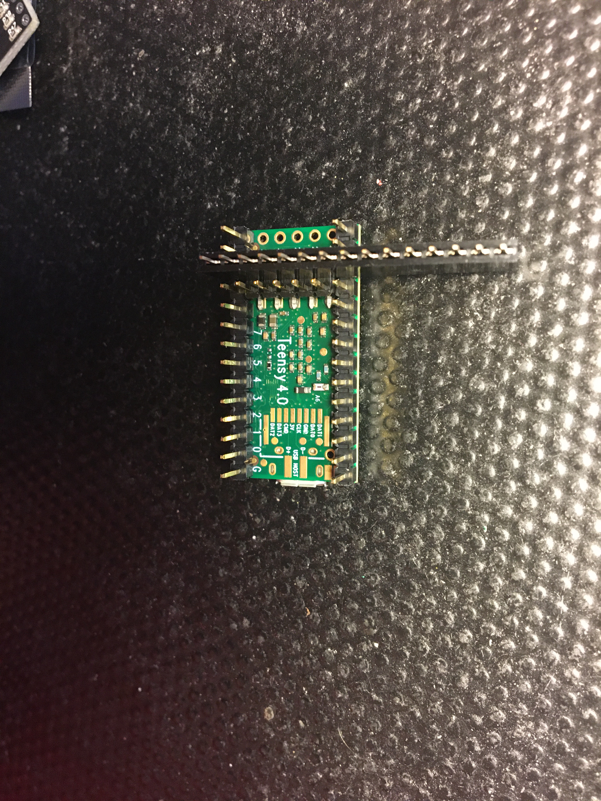
docs/images/build/Photo 23-04-2022, 18 36 19.jpg
