pigatron-industries/xen_octasource/docs/images/build/Photo 23-04-2022, 19 01 36.jpg

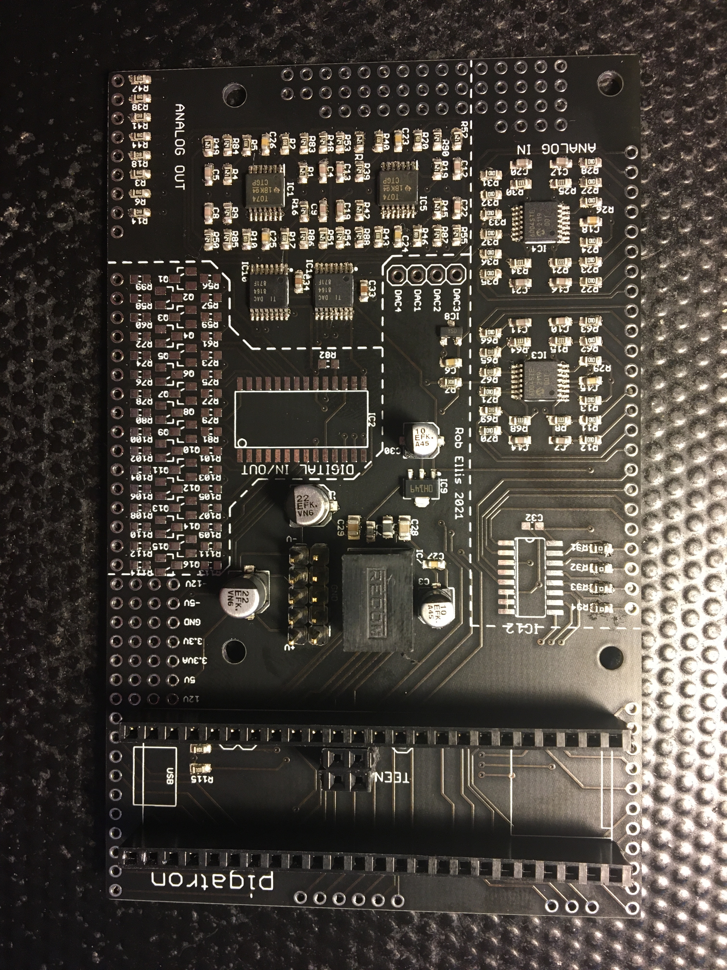
docs/images/build/Photo 23-04-2022, 19 01 36.jpg
