pigatron-industries/xen_octasource/docs/images/build/Photo 24-04-2022, 14 49 06.jpg

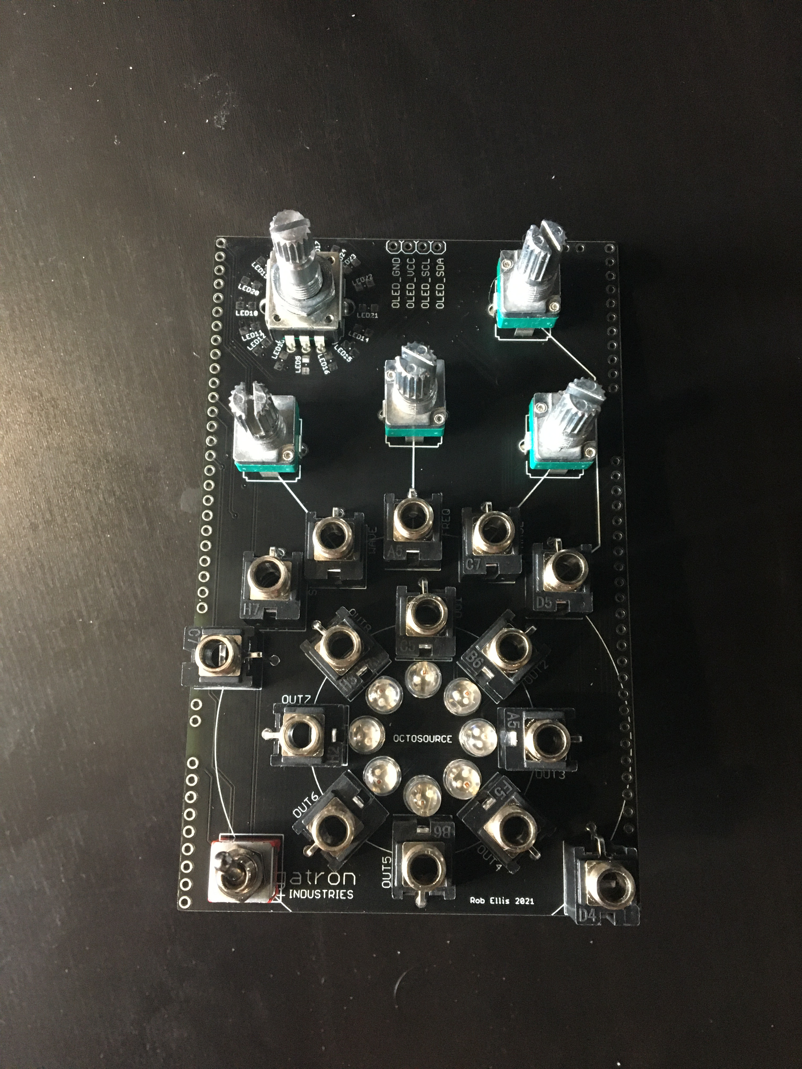
docs/images/build/Photo 24-04-2022, 14 49 06.jpg
